ajisrawi/hologuard-hg1-radar/board/renders/HG1-ANT_iso_bottom.png

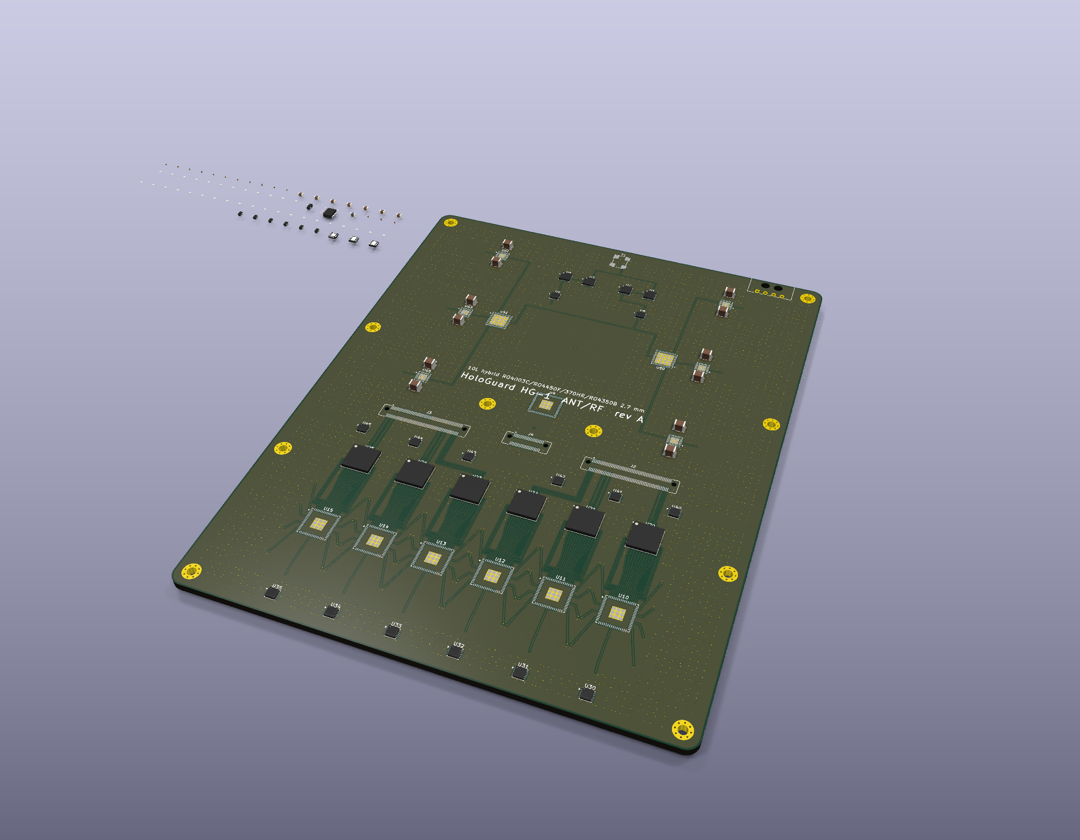
board/renders/HG1-ANT_iso_bottom.png
