ajisrawi/hologuard-hg1-radar/board/renders/HG1-ANT_top.png

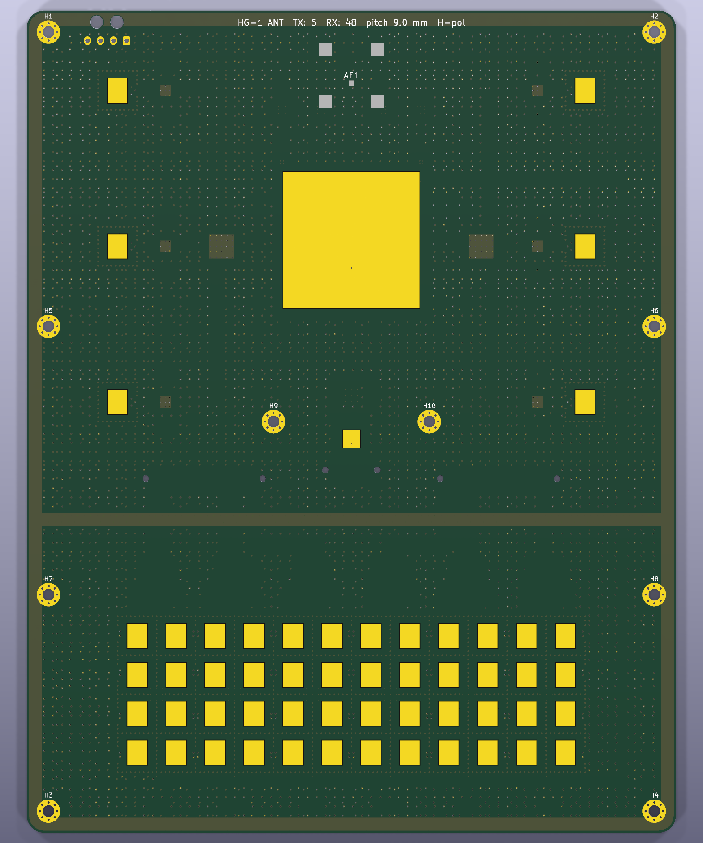
board/renders/HG1-ANT_top.png
