ajisrawi/hologuard-hg1-radar/board/renders/HG1-PWR_bottom.png

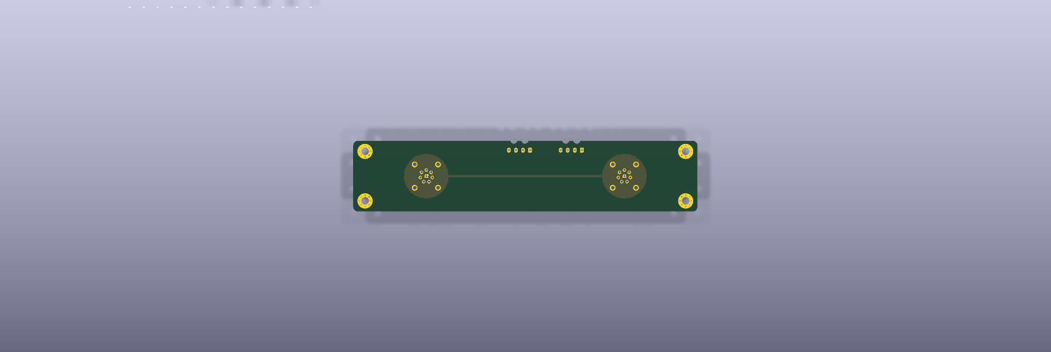
board/renders/HG1-PWR_bottom.png
