ajisrawi/hologuard-hg1-radar/board/schematic/pdf/HG1-ANT_detail.png

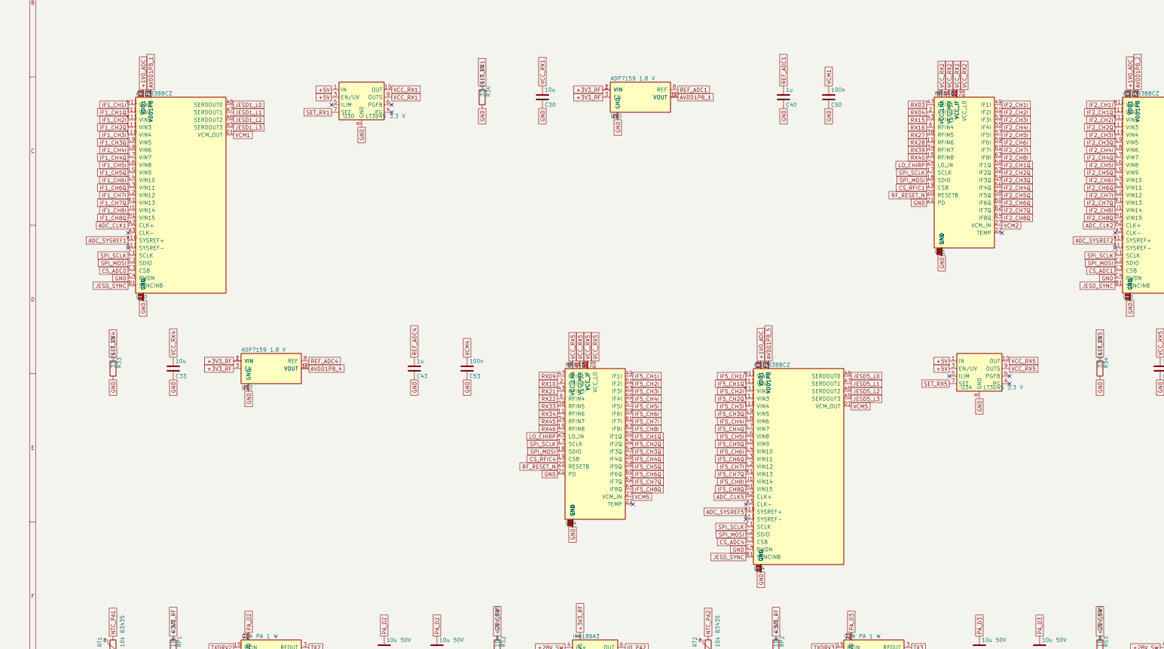
board/schematic/pdf/HG1-ANT_detail.png
