ajisrawi/hologuard-hg1-radar/board/schematic/pdf/HG1-DSP_overview.png

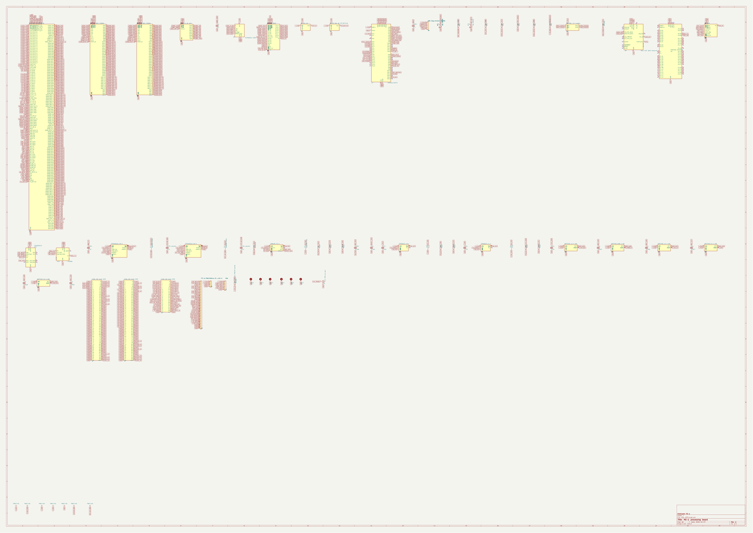
board/schematic/pdf/HG1-DSP_overview.png
