ajisrawi/hologuard-hg1-radar/board/schematic/pdf/HG1-PWR_detail.png

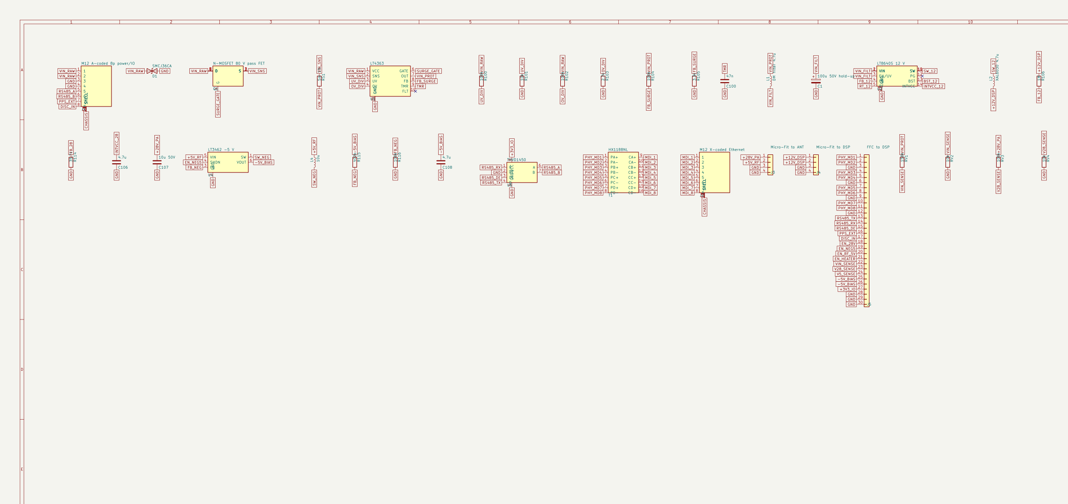
board/schematic/pdf/HG1-PWR_detail.png
