ajisrawi/hologuard-hg1-radar/board/schematic/pdf/HG1-PWR_overview.png

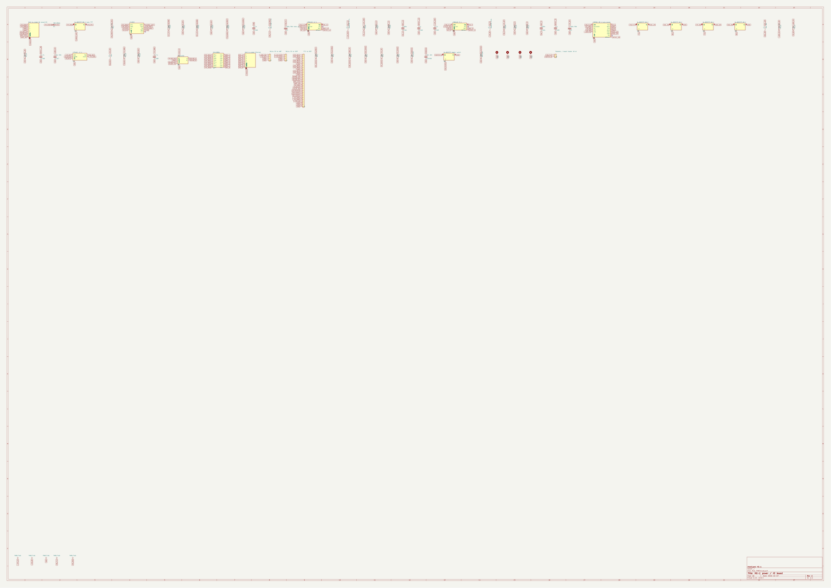
board/schematic/pdf/HG1-PWR_overview.png
