ajisrawi/hologuard-hg1-radar/mech/out/gnss_patch.stl

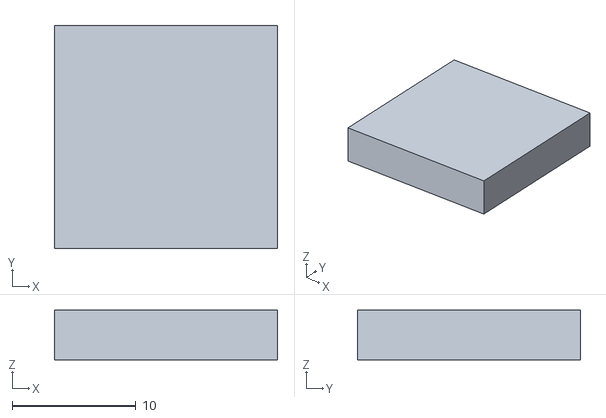
[picture p32: CAD file, 2026-10-08]
mech/out/gnss_patch.stl
18.0 x 18.0 x 4.00
