ajisrawi/hologuard-hg1-radar/mech/out/iso_fence.stl

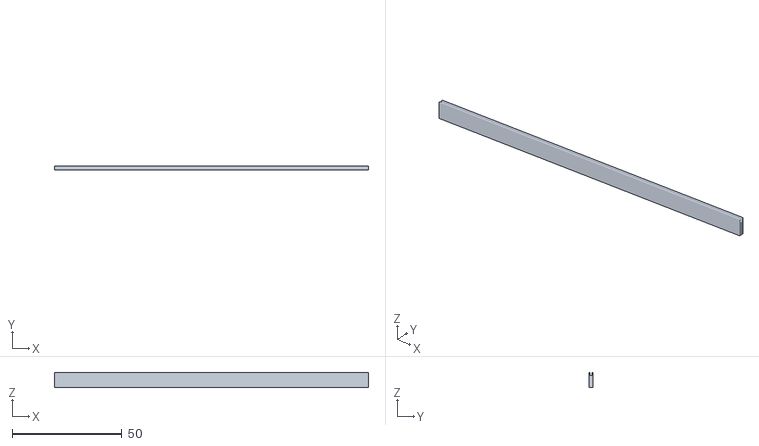
[picture p33: CAD file, 2026-10-08]
mech/out/iso_fence.stl
143.0 x 2.00 x 6.98
