ajisrawi/hologuard-hg1-radar/mech/out/ant_pcb.stl

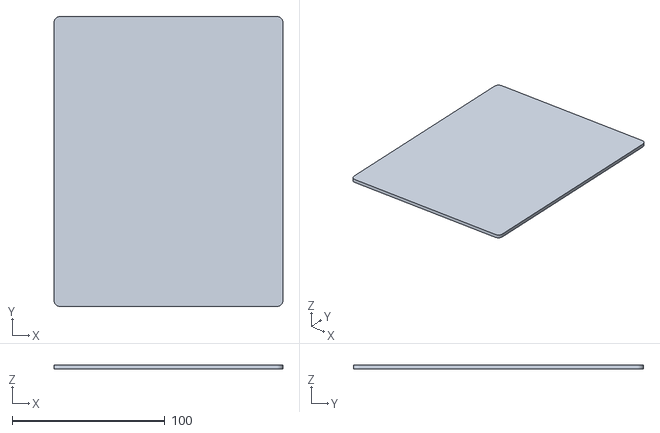
[picture p34: CAD file, 2026-10-08]
mech/out/ant_pcb.stl
150.0 x 190.0 x 2.72
