ajisrawi/hologuard-hg1-radar/mech/out/HG1_enclosure.step

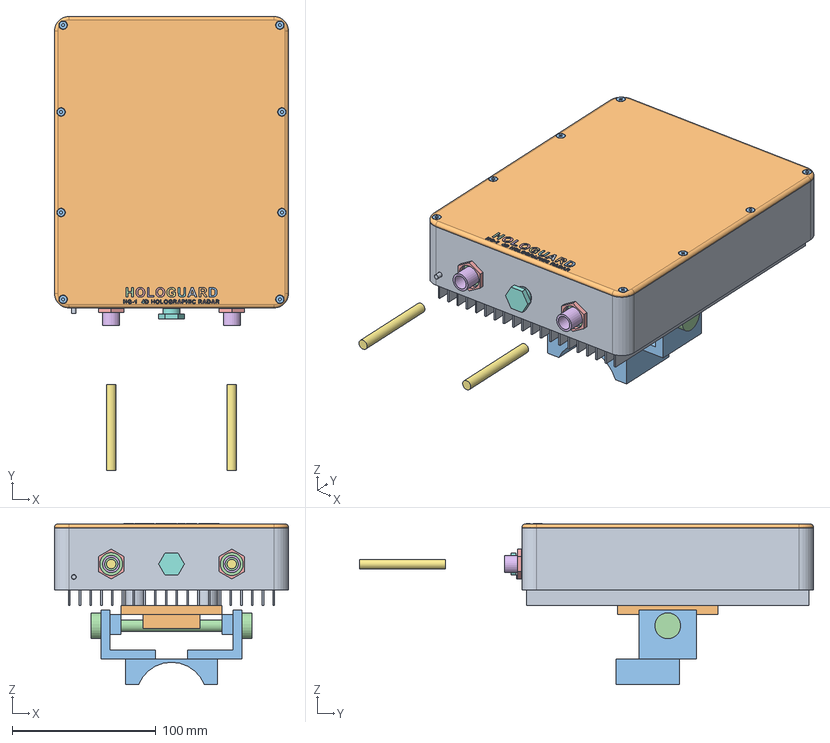
[picture p35: CAD file, 2026-10-08]
mech/out/HG1_enclosure.step
163.0 x 316.2 x 112.3 mm
housing
radome
radome_screws
logo
ant_pcb
ant_copper
gnss_patch
iso_fence
absorber
shield_frame
dsp_pcb
versal
tim_pad
pwr_pcb
connectors
bracket
bracket_hw
