ajisrawi/hologuard-hg1-radar/mech/out/ant_copper.stl

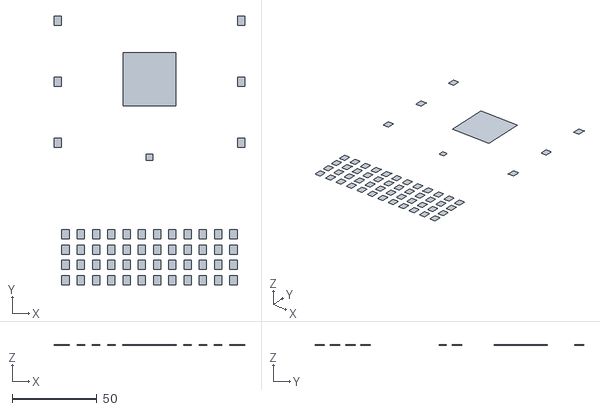
[picture p36: CAD file, 2026-10-08]
mech/out/ant_copper.stl
112.5 x 158.6 x 0.06
