ajisrawi/hologuard-hg1-radar/mech/out/pole.stl

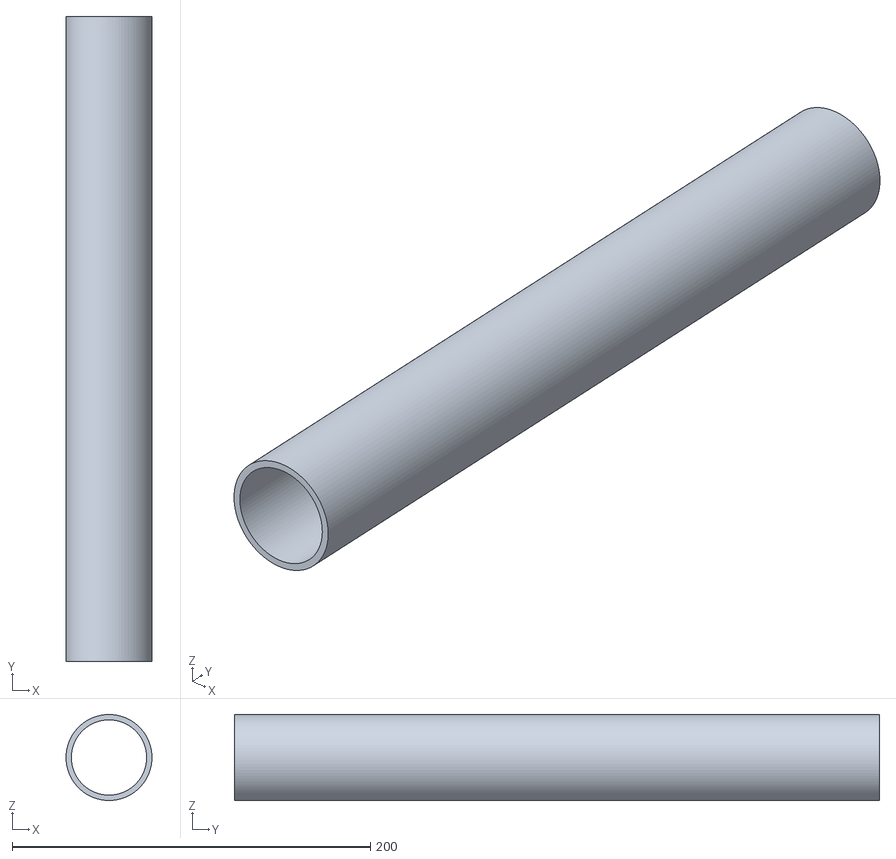
[picture p37: CAD file, 2026-10-07]
mech/out/pole.stl
48.0 x 360.0 x 48.0
