ajisrawi/hologuard-hg1-radar/mech/out/m12_plugs.stl

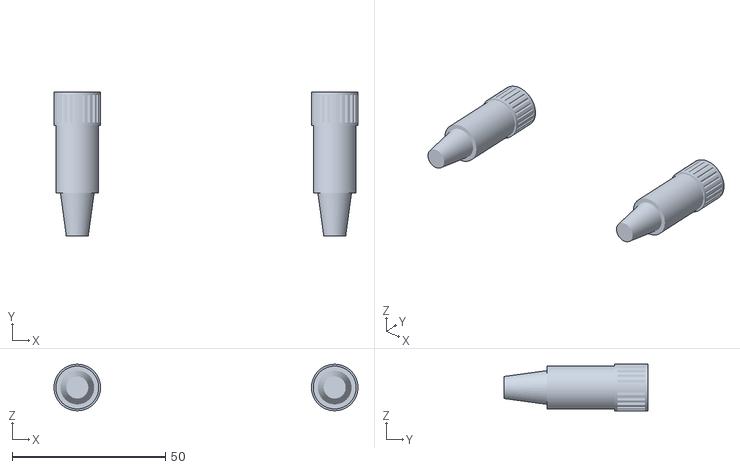
[picture p38: CAD file, 2026-10-07]
mech/out/m12_plugs.stl
99.2 x 47.0 x 15.2
