ajisrawi/hologuard-hg1-radar/mech/out/bracket.stl

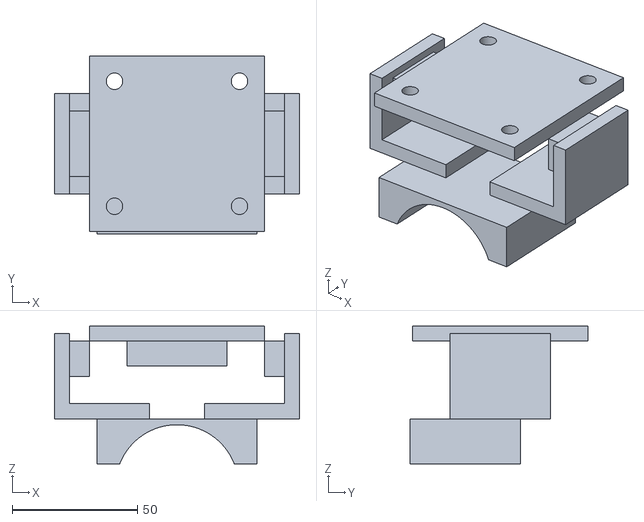
[picture p39: CAD file, 2026-10-07]
mech/out/bracket.stl
98.0 x 71.0 x 55.0
