ajisrawi/hologuard-hg1-radar/mech/out/connectors.stl

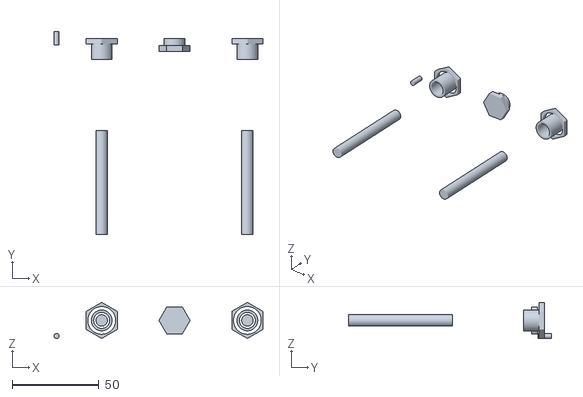
[picture p40: CAD file, 2026-10-07]
mech/out/connectors.stl
120.5 x 117.2 x 20.9
