ajisrawi/hologuard-hg1-radar/mech/out/radome.stl

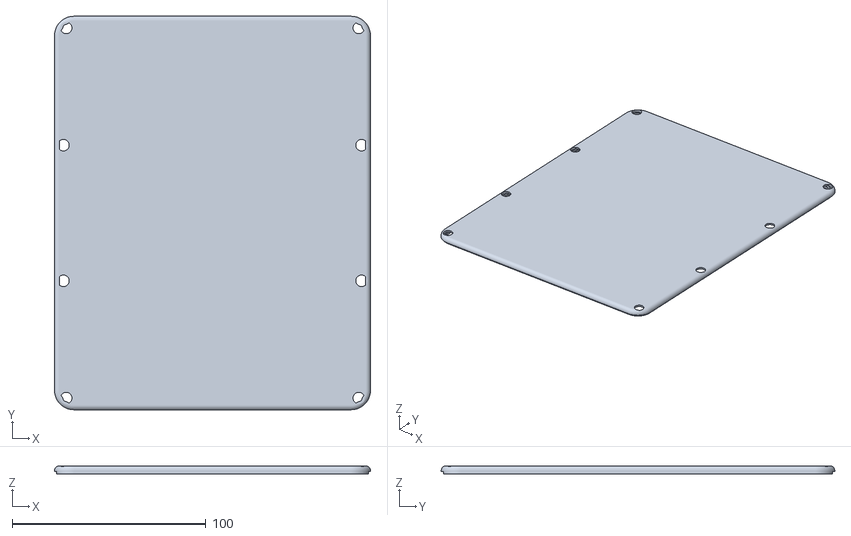
[picture p41: CAD file, 2026-10-07]
mech/out/radome.stl
163.0 x 203.0 x 4.20
