ajisrawi/hologuard-hg1-radar/mech/out/tim_pad.stl

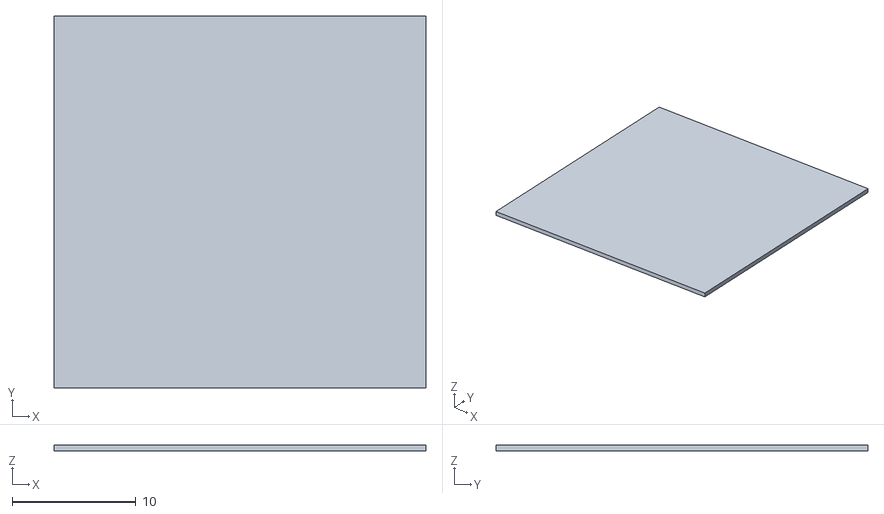
[picture p42: CAD file, 2026-10-07]
mech/out/tim_pad.stl
30.0 x 30.0 x 0.5
