ajisrawi/hologuard-hg1-radar/mech/out/versal.stl

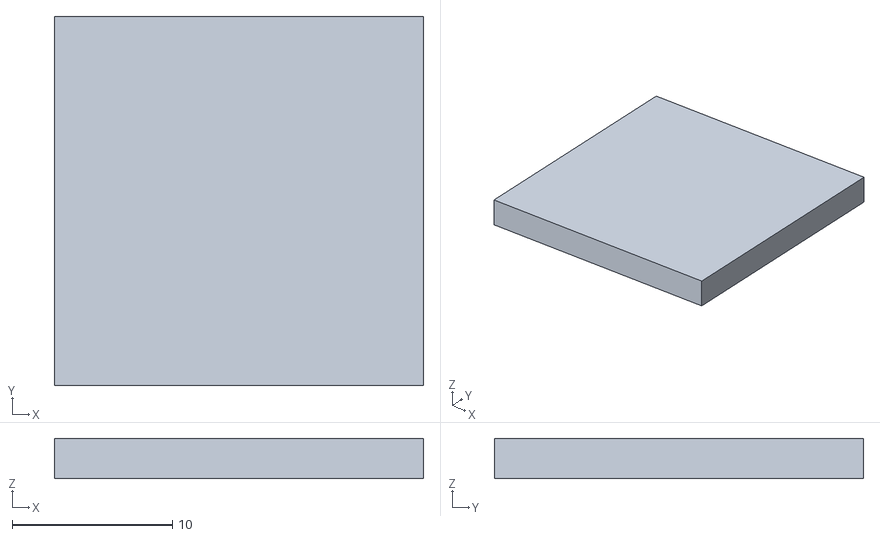
[picture p43: CAD file, 2026-10-07]
mech/out/versal.stl
23.0 x 23.0 x 2.50
