ajisrawi/hologuard-hg1-radar/mech/out/absorber.stl

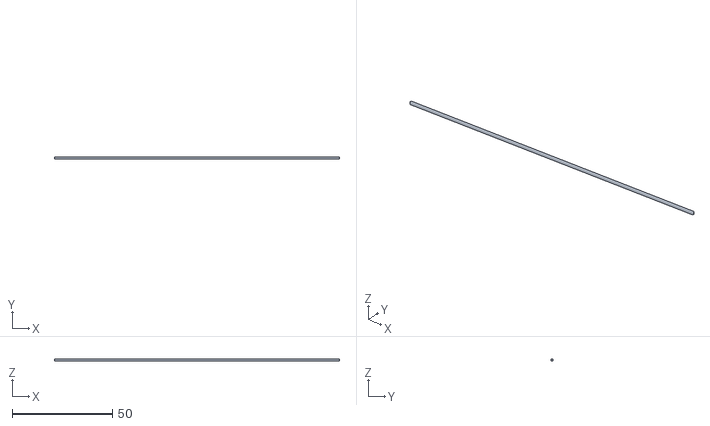
[picture p44: CAD file, 2026-10-07]
mech/out/absorber.stl
142.0 x 0.8 x 1.20
