ajisrawi/hologuard-hg1-radar/mech/out/bracket_hw.stl

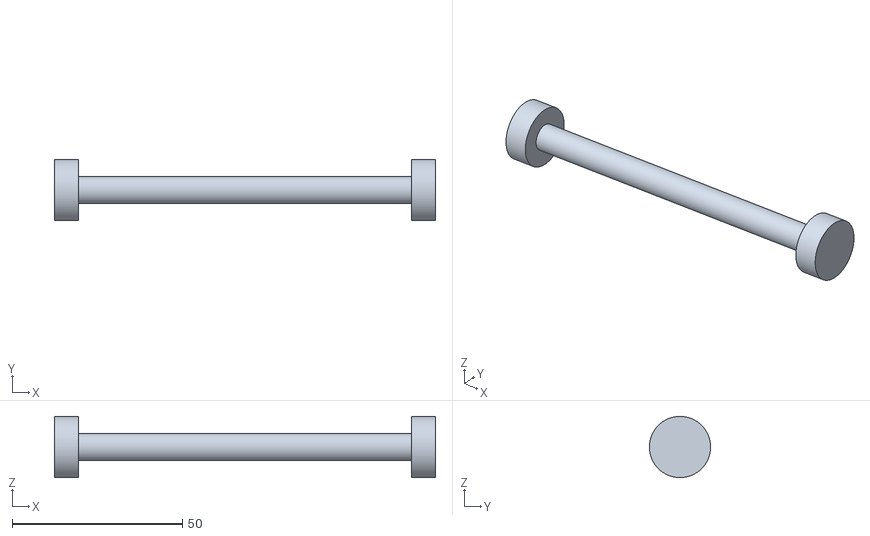
[picture p45: CAD file, 2026-10-07]
mech/out/bracket_hw.stl
112.0 x 18.0 x 18.0
