ajisrawi/hologuard-hg1-radar/mech/out/pwr_pcb.stl

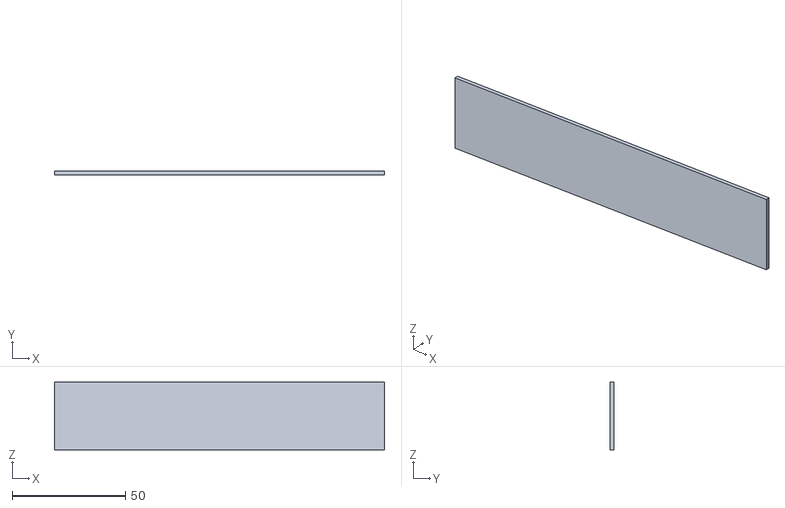
[picture p46: CAD file, 2026-10-07]
mech/out/pwr_pcb.stl
146.0 x 1.60 x 30.0
