ajisrawi/hologuard-hg1-radar/mech/out/shield_frame.stl

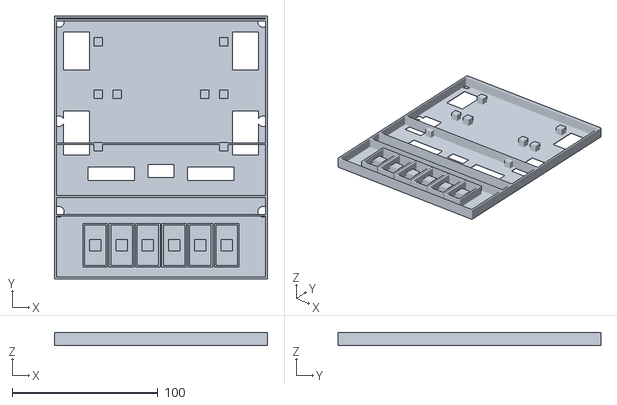
[picture p47: CAD file, 2026-10-07]
mech/out/shield_frame.stl
146.0 x 180.0 x 8.85
