ajisrawi/hologuard-hg1-radar/mech/out/housing.stl

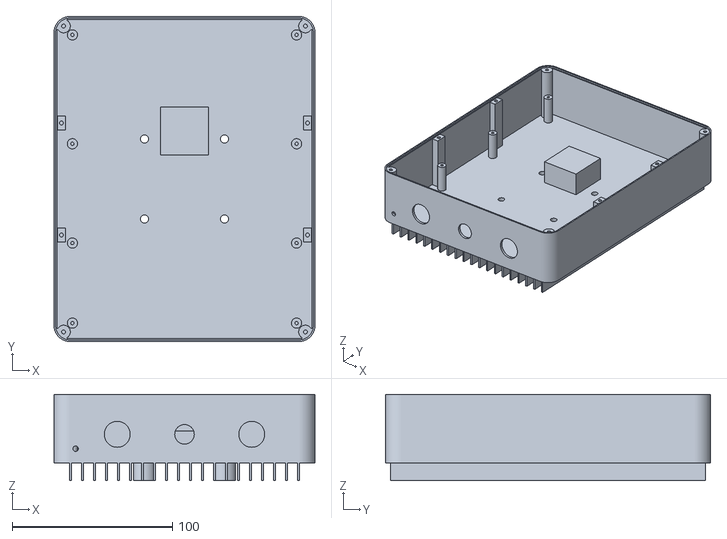
[picture p48: CAD file, 2026-10-07]
mech/out/housing.stl
163.0 x 203.0 x 54.0
