ajisrawi/hologuard-hg1-radar/mech/out/dsp_pcb.stl

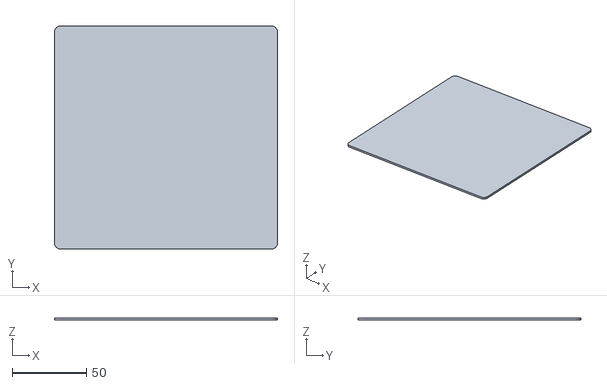
[picture p49: CAD file, 2026-10-07]
mech/out/dsp_pcb.stl
150.0 x 150.0 x 1.60
