ajisrawi/hologuard-hg1-radar/mech/out/logo.stl

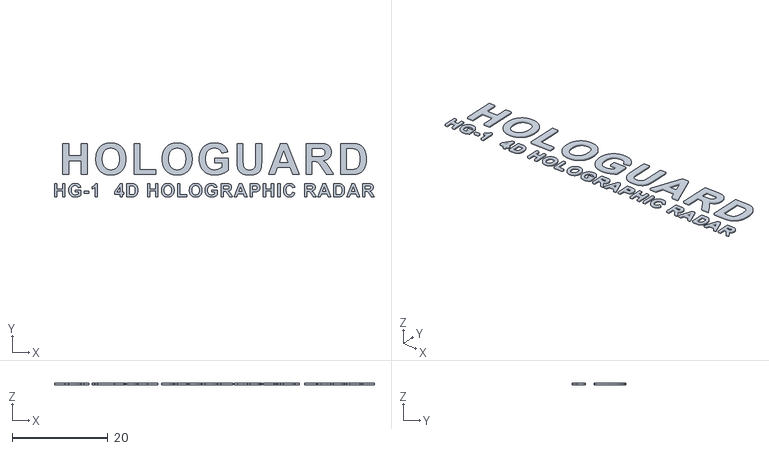
[picture p50: CAD file, 2026-10-07]
mech/out/logo.stl
66.9 x 11.4 x 0.35
