ajisrawi/hologuard-hg1-radar/(list of files, cad)

Other CAD files:
mech/out/HG1_enclosure.FCStd
mech/out/radome_screws.stl
render/HG1_scene.blend
