ajisrawi/hologuard-hg1-radar/antenna/em/results/opt_log.csv

n | drv_l | par_l | slot_l | arm_l | stub | cost_dB
1 | 3.000 | 4.250 | 4.088 | 1.600 | 2.772 | -12.78
2 | 3.150 | 4.250 | 4.088 | 1.600 | 2.772 | -7.89
3 | 3.000 | 4.450 | 4.088 | 1.600 | 2.772 | -10.80
4 | 3.000 | 4.250 | 4.338 | 1.600 | 2.772 | -10.81
5 | 3.000 | 4.250 | 4.088 | 1.800 | 2.772 | -8.66
