ajisrawi/hologuard-hg1-radar/antenna/em/results/opt_log_v1_worstcase.csv

n | drv_l | par_l | slot_l | arm_l | stub | worst_dB
1 | 3.600 | 4.600 | 3.600 | 1.000 | 2.500 | -1.20
2 | 3.850 | 4.600 | 3.600 | 1.000 | 2.500 | -0.28
3 | 3.600 | 4.900 | 3.600 | 1.000 | 2.500 | -0.68
4 | 3.600 | 4.600 | 4.000 | 1.000 | 2.500 | -0.73
5 | 3.600 | 4.600 | 3.600 | 1.300 | 2.500 | -0.74
7 | 3.700 | 4.720 | 3.760 | 1.120 | 2.200 | -0.32
