ajisrawi/hologuard-hg1-radar/antenna/em/results/opt_log_v2a.csv

n | drv_l | par_l | slot_l | arm_l | stub | cost_dB
1 | 3.600 | 4.600 | 3.600 | 1.000 | 2.500 | -4.98
2 | 3.850 | 4.600 | 3.600 | 1.000 | 2.500 | -1.08
3 | 3.600 | 4.900 | 3.600 | 1.000 | 2.500 | -3.27
4 | 3.600 | 4.600 | 4.000 | 1.000 | 2.500 | -2.91
5 | 3.600 | 4.600 | 3.600 | 1.300 | 2.500 | -2.66
6 | 3.600 | 4.600 | 3.600 | 1.000 | 2.800 | -5.24
7 | 3.350 | 4.720 | 3.760 | 1.120 | 2.620 | -7.18
8 | 3.100 | 4.780 | 3.840 | 1.180 | 2.680 | -4.90
9 | 3.500 | 4.768 | 3.824 | 0.748 | 2.668 | -6.19
10 | 3.460 | 4.835 | 3.354 | 0.947 | 2.735 | -4.93
11 | 3.404 | 4.509 | 3.655 | 0.926 | 2.829 | -6.47
12 | 3.522 | 4.444 | 4.022 | 0.970 | 2.632 | -5.80
13 | 3.350 | 4.616 | 3.944 | 0.906 | 2.920 | -7.07
14 | 3.250 | 4.623 | 4.082 | 0.868 | 2.667 | -5.67
15 | 3.338 | 4.617 | 3.962 | 0.901 | 2.701 | -7.16
16 | 3.255 | 4.849 | 3.636 | 0.870 | 2.863 | -2.44
17 | 3.455 | 4.545 | 3.926 | 0.945 | 2.690 | -7.72
18 | 3.259 | 4.435 | 3.875 | 1.171 | 2.836 | -9.16
19 | 3.138 | 4.269 | 3.900 | 1.383 | 2.919 | -11.19
20 | 3.248 | 4.598 | 4.142 | 1.176 | 2.710 | -8.81
21 | 3.262 | 4.483 | 3.931 | 1.304 | 2.536 | -8.86
22 | 3.244 | 4.428 | 3.902 | 1.470 | 2.690 | -7.83
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
