ajisrawi/hologuard-hg1-radar/antenna/em/results/optm_log.csv

gen | idx | drv_l | par_l | slot_l | arm_l | stub | h_par | cost_dB | per_angle_dB
0 | 0 | 3.0000 | 4.2500 | 4.0880 | 1.6000 | 2.7720 | 1.5240 | -3.21 | -11.50 -6.19 -3.21
0 | 1 | 3.8086 | 4.8620 | 3.9450 | 1.6952 | 2.7925 | 1.2190 | -0.59 | -0.59 -0.71 -5.66
0 | 2 | 3.3720 | 4.9911 | 2.9958 | 1.3785 | 2.9988 | 1.0160 | -1.46 | -1.99 -1.46 -3.33
0 | 3 | 2.8249 | 4.3546 | 2.5397 | 0.4218 | 1.7623 | 1.0160 | -0.34 | -0.34 -0.57 -2.39
0 | 4 | 2.9572 | 5.4184 | 4.4028 | 1.2173 | 2.6609 | 0.8130 | -1.03 | -1.34 -1.03 -2.90
0 | 5 | 2.5837 | 4.4555 | 4.5124 | 0.9871 | 1.8301 | 1.2190 | -1.81 | -1.81 -1.81 -2.89
0 | 6 | 3.0067 | 4.1453 | 3.2019 | 2.0601 | 2.2592 | 1.2190 | -8.05 | -11.34 -8.05 -10.37
0 | 7 | 3.5892 | 4.2299 | 4.0003 | 0.5114 | 2.5886 | 1.5240 | -2.63 | -6.56 -4.58 -2.63
0 | 8 | 3.9888 | 5.4022 | 3.6398 | 1.9846 | 2.1501 | 1.2190 | -0.06 | -0.06 -0.06 -0.12
0 | 9 | 2.8064 | 5.1414 | 2.6027 | 1.9028 | 1.6124 | 1.2190 | -1.64 | -2.20 -1.64 -1.92
0 | 10 | 3.2419 | 4.6582 | 3.5945 | 0.7380 | 2.7198 | 1.0160 | -0.94 | -1.03 -0.94 -2.50
0 | 11 | 2.4989 | 3.5233 | 2.4000 | 1.0241 | 1.9506 | 1.2190 | -2.08 | -2.08 -6.17 -7.66
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
