ajisrawi/hologuard-hg1-radar/firmware/sim/results/microdoppler_feature.png

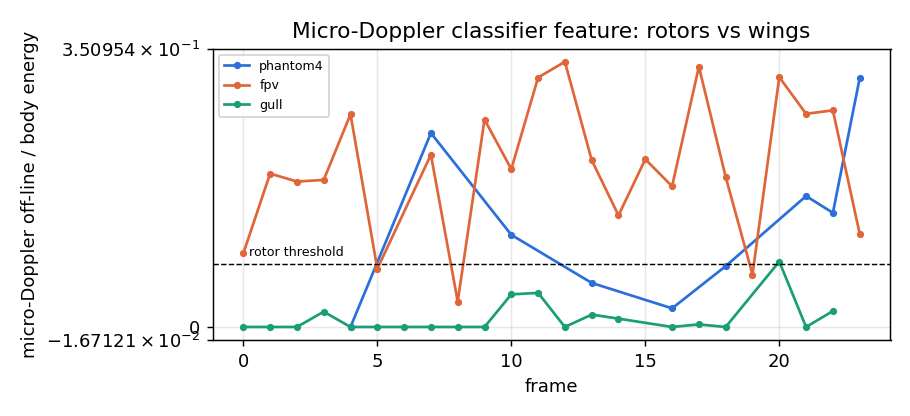
firmware/sim/results/microdoppler_feature.png
