ajisrawi/hologuard-hg1-radar/firmware/sim/results/tracks_vs_truth.png

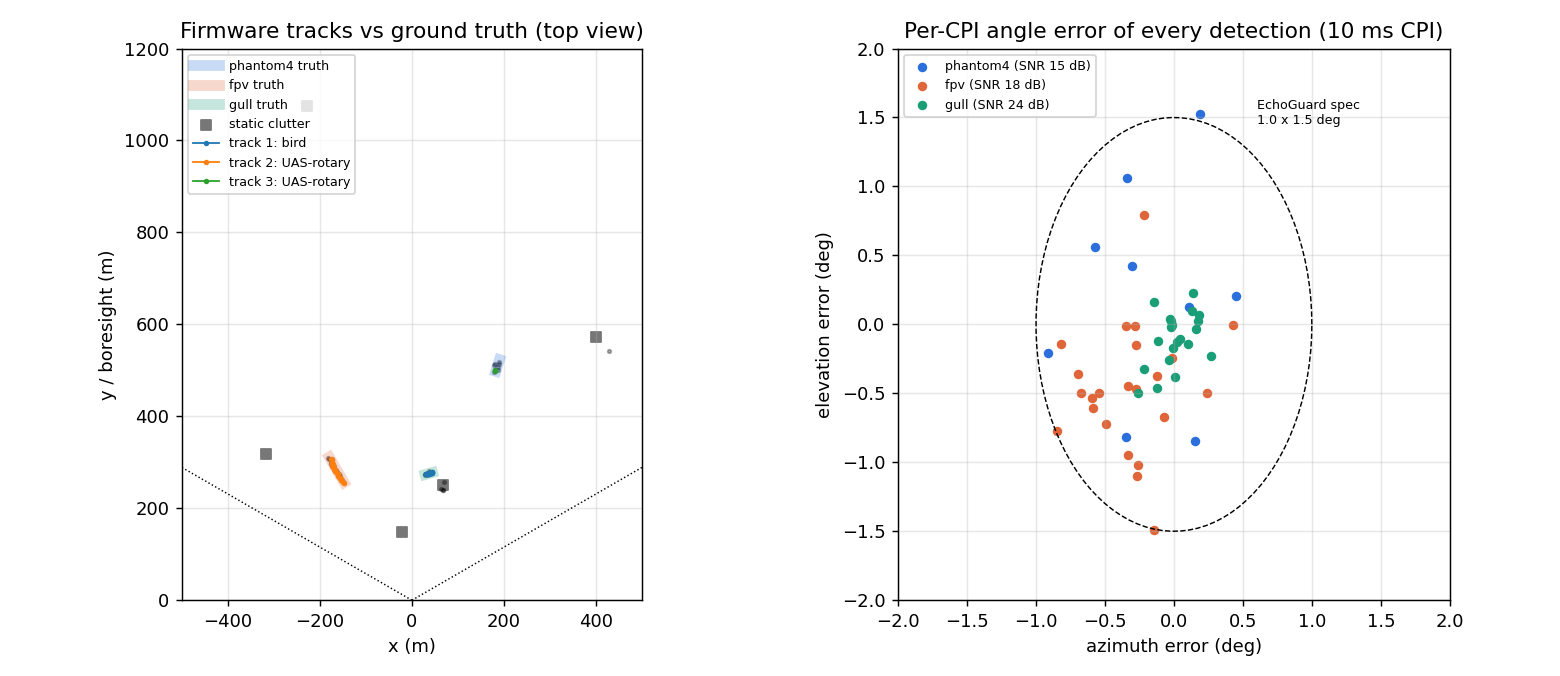
firmware/sim/results/tracks_vs_truth.png
