ajisrawi/hologuard-hg1-radar/board/schematic/pdf/HG1-ANT.pdf

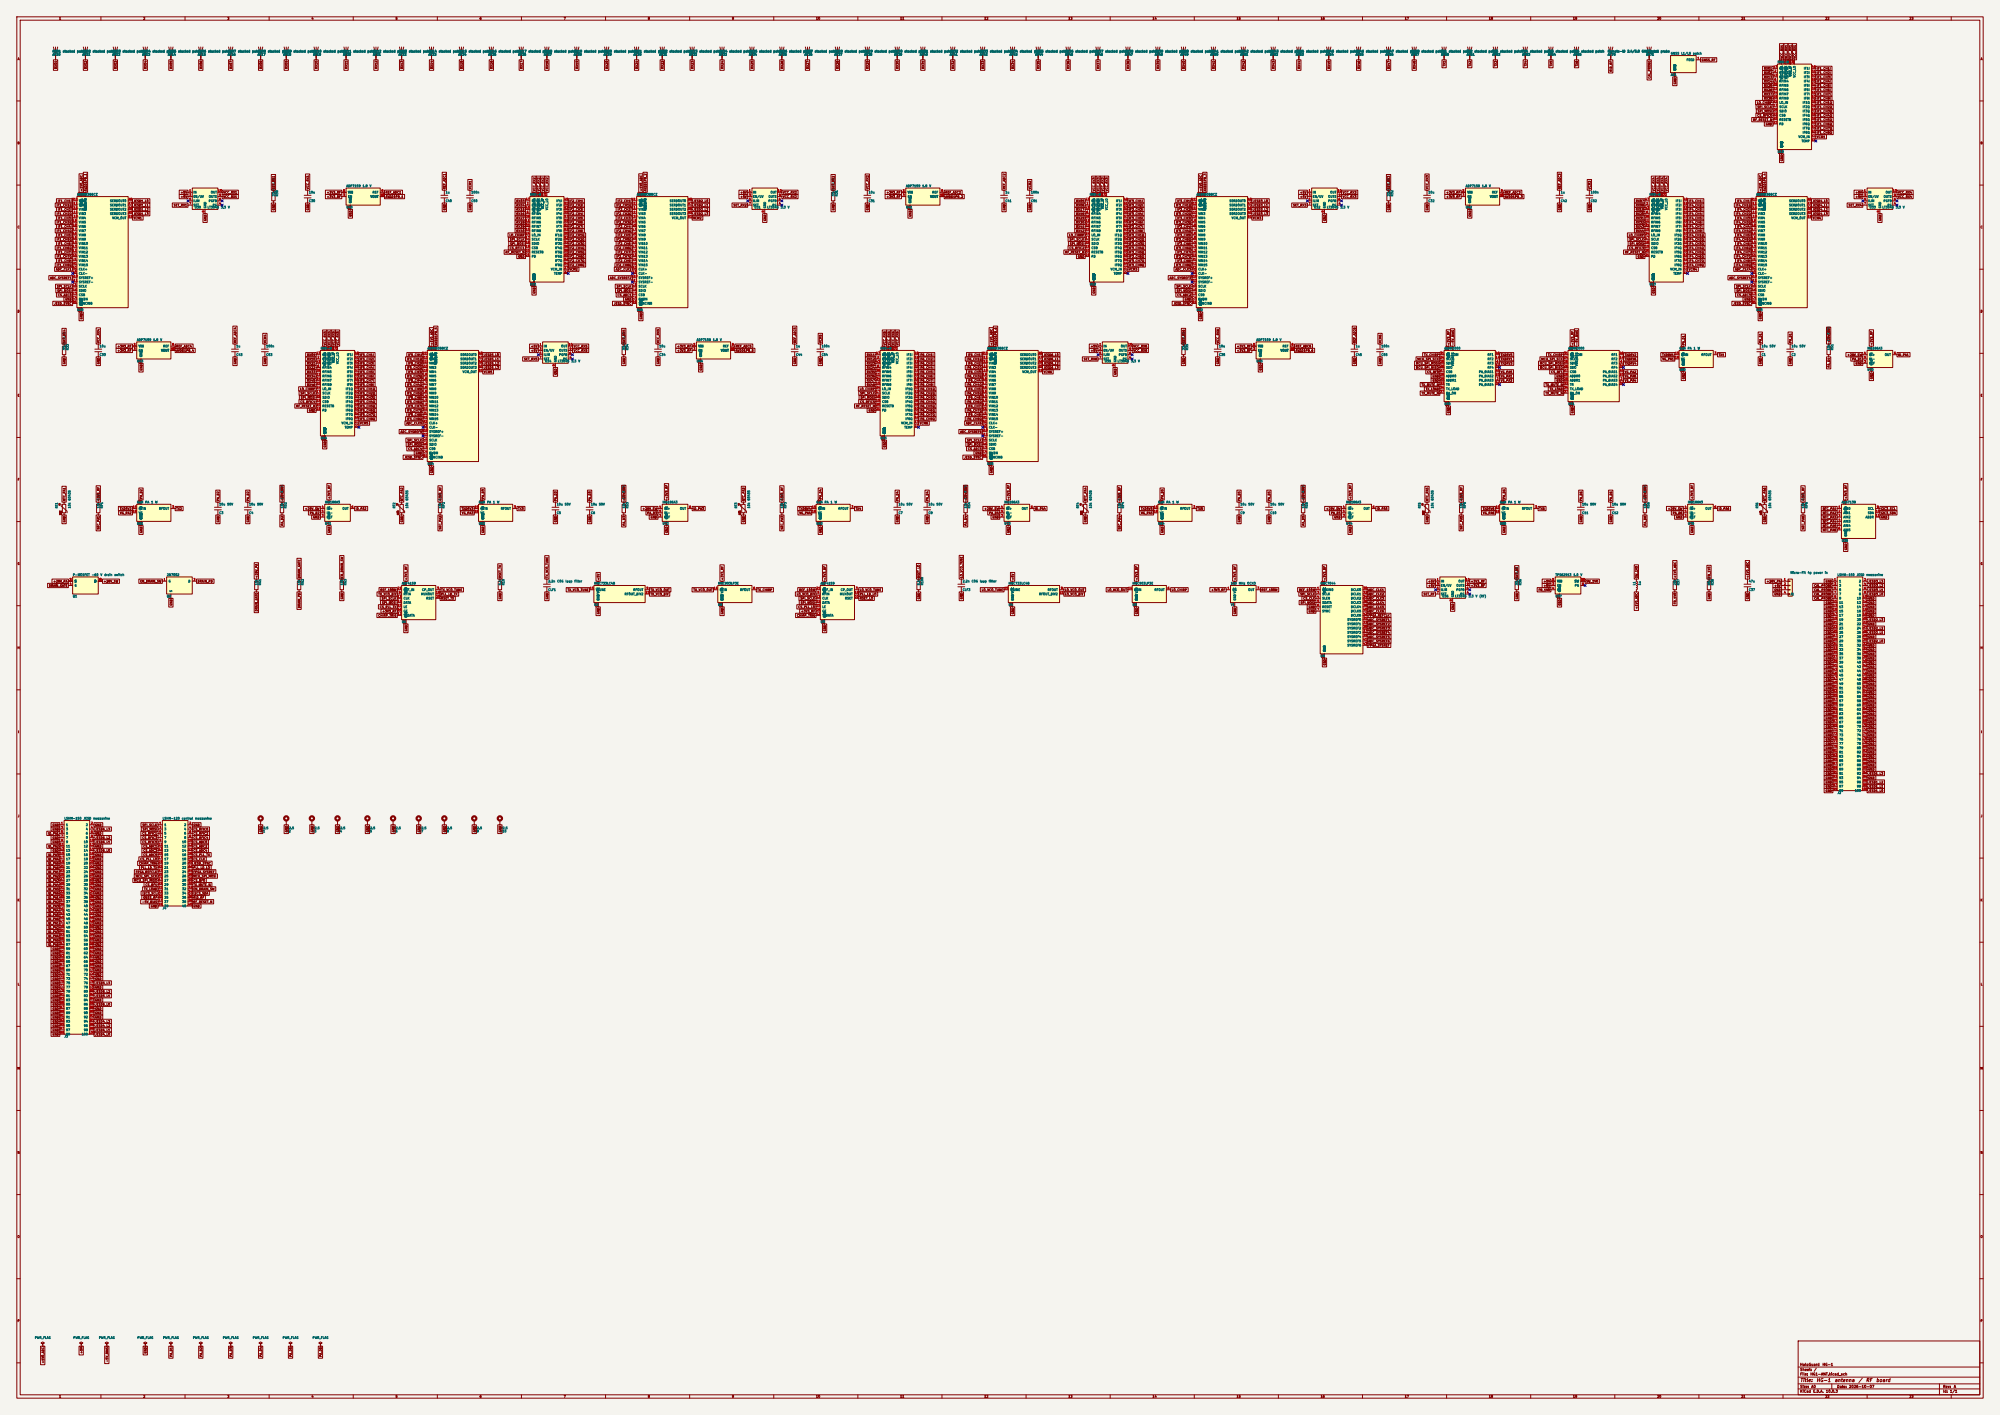
[picture p53: page 1]

HoloGuard HG-1
Sheet: /
File: HG1-ANT.kicad_sch
Title: HG-1 antenna / RF board

Size: A0 | Rev: A
KiCad E.D.A. 10.0.3 | Id: 1/1
