ajisrawi/hologuard-hg1-radar/board/schematic/pdf/HG1-DSP.pdf

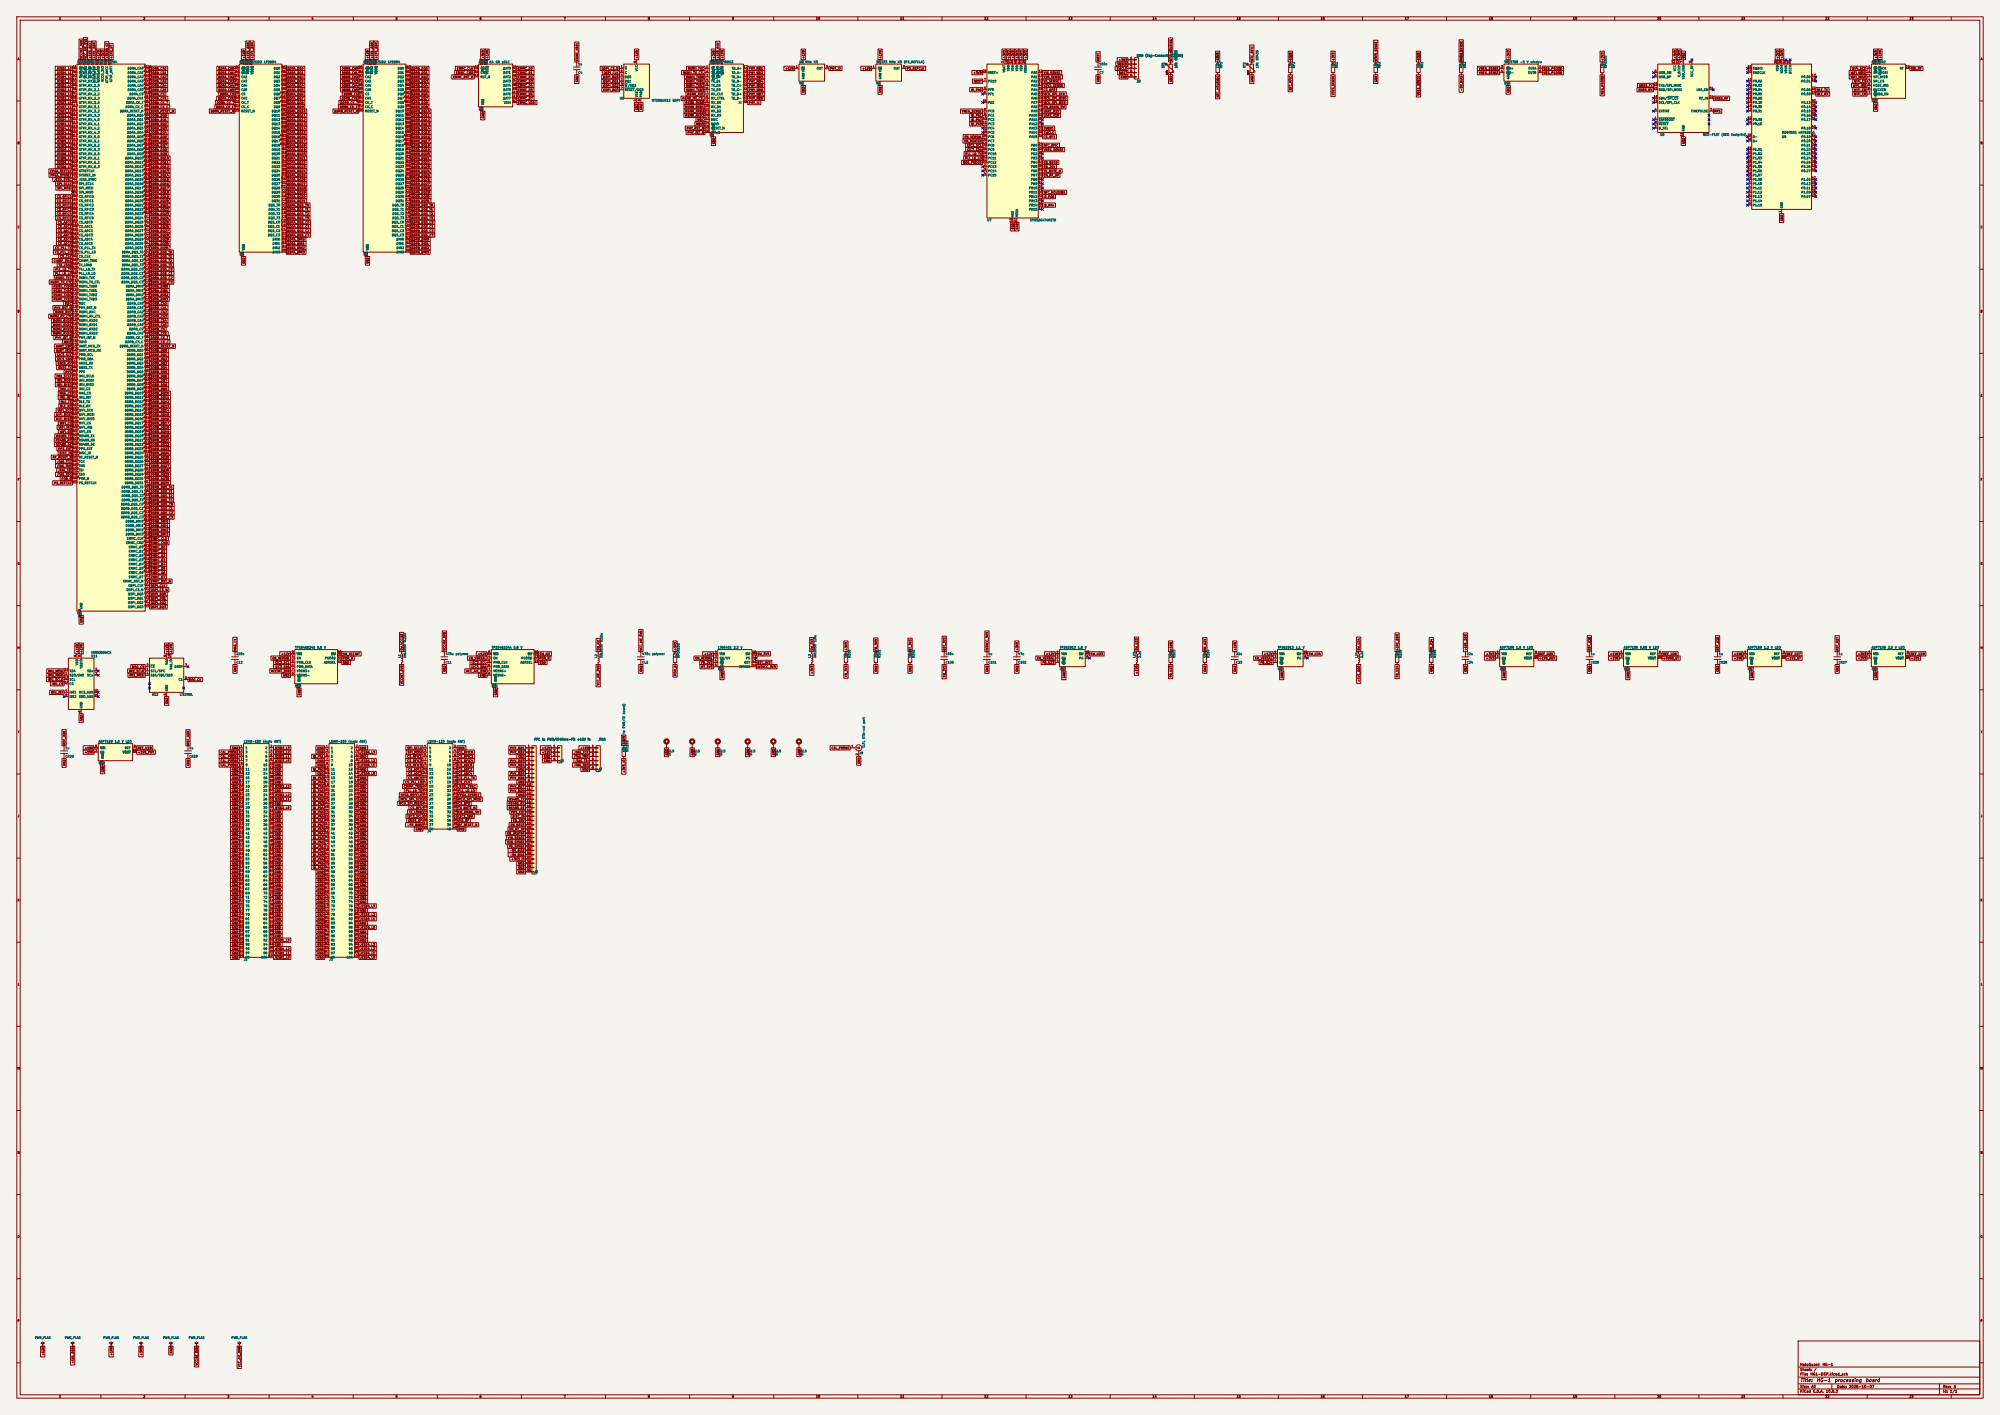
[picture p54: page 1]

TDO AG27POR_B AG28PS_REFCLK AH1 VCCINT AH2 VCC_AIE AH3 VCCAUX AH4 VCCO_DDR AH5 VCCO_1V8 AH6 VCCO_3V3 AH7 GTYP_AVCC AH8 GTYP_AVTT AH9 GND AH10 U1

2J9 U.FL OTA-cal port

FFC to PWR/IO

Sheet: /
File: HG1-DSP.kicad_sch
Title: HG-1 processing board

Size: A0 | Rev: A
KiCad E.D.A. 10.0.3 | Id: 1/1
