ajisrawi/hologuard-hg1-radar/board/schematic/pdf/HG1-PWR.pdf

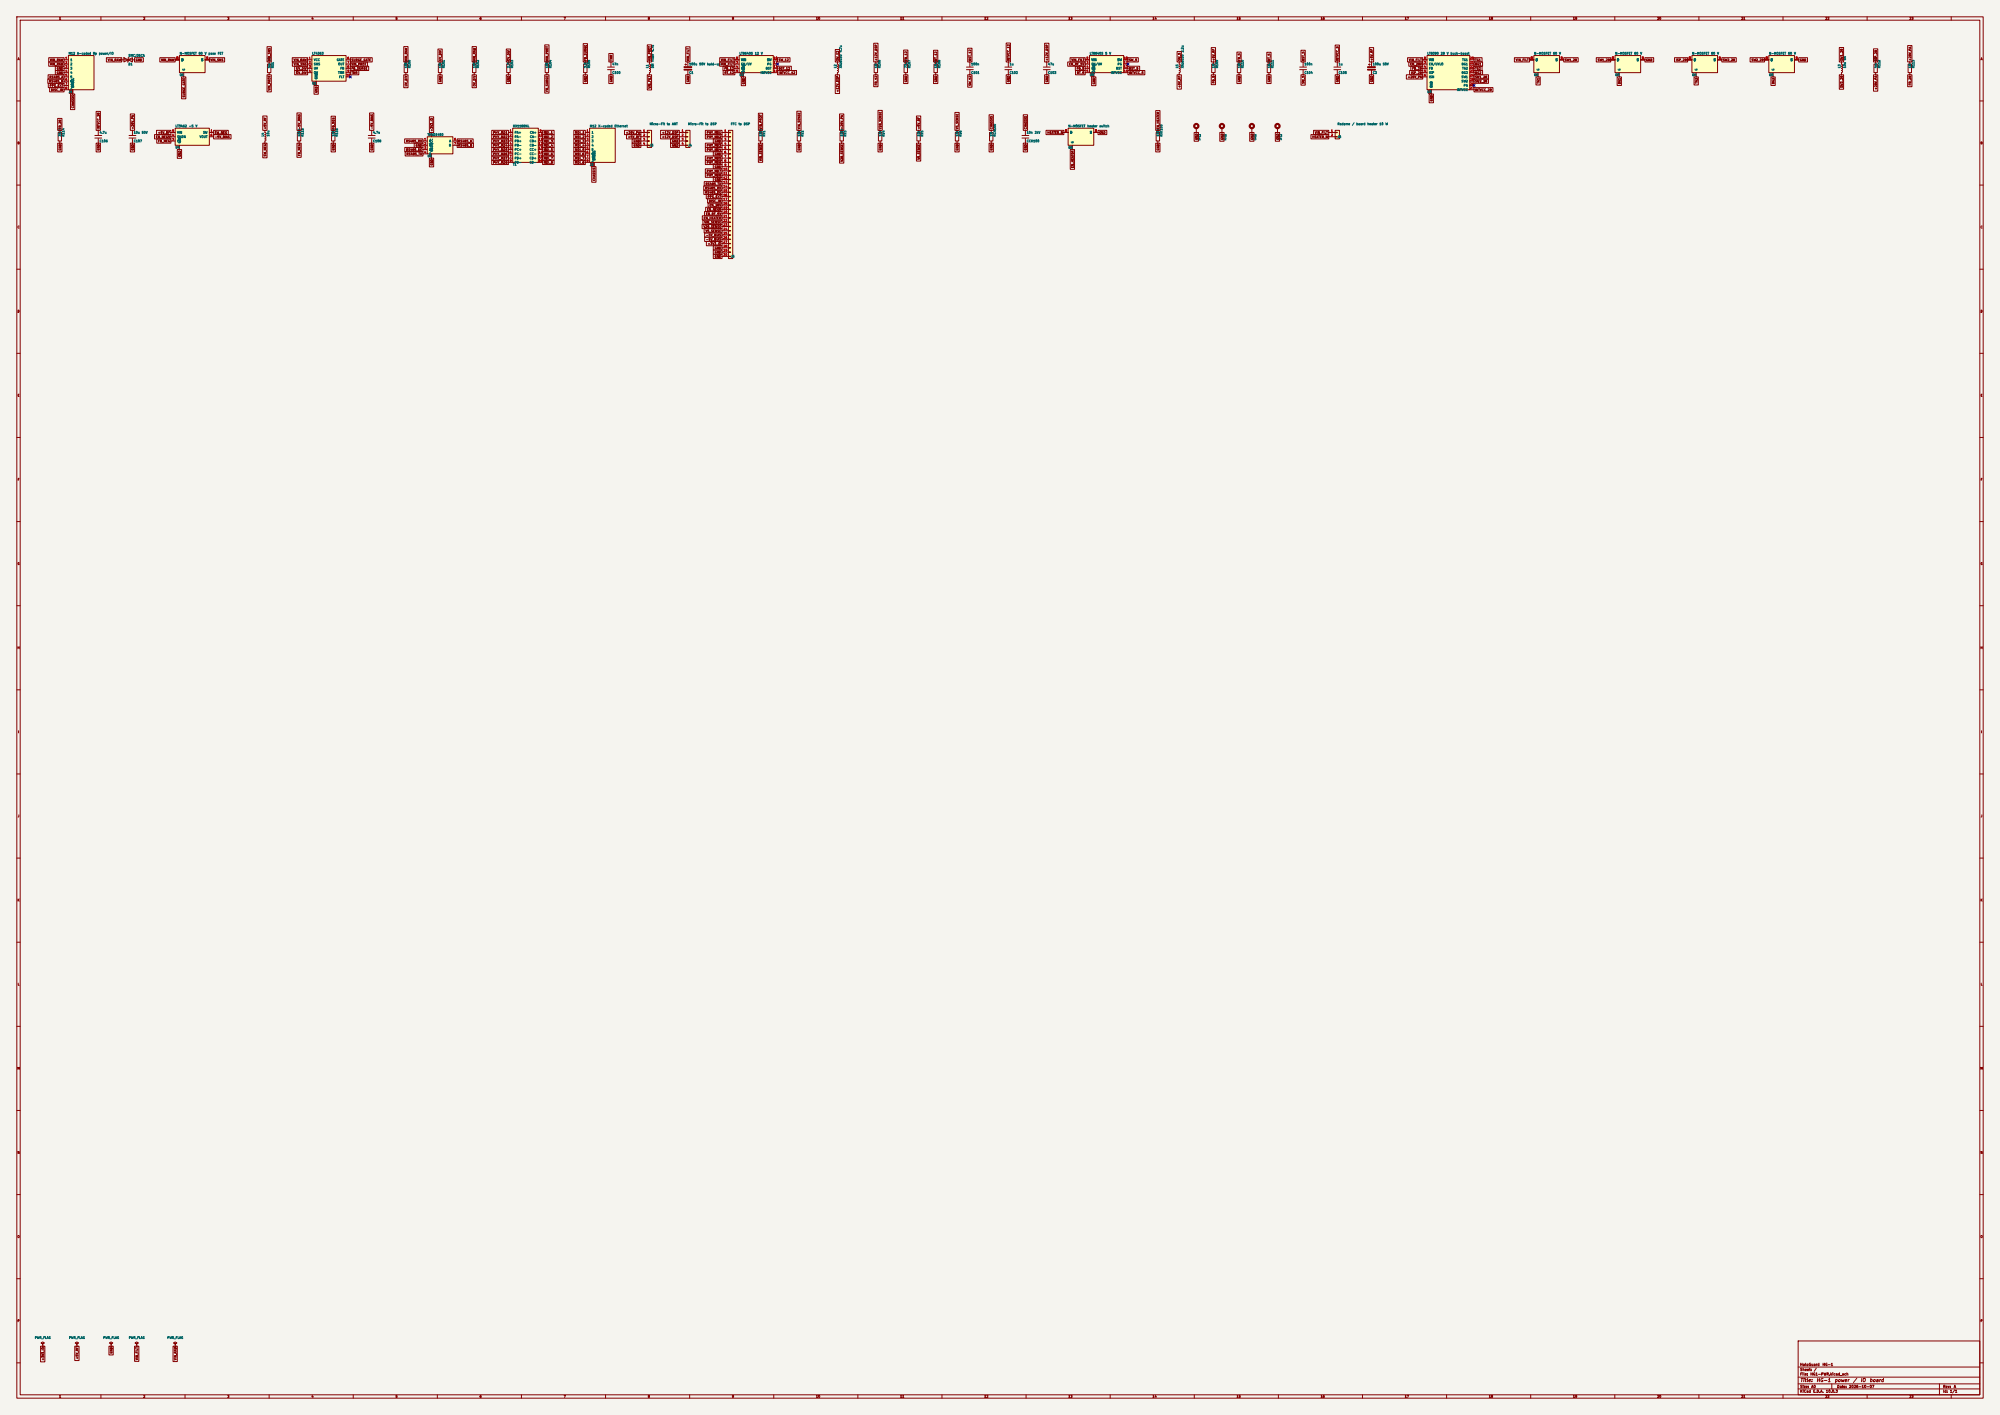
[picture p55: page 1]

HoloGuard HG-1
Sheet: /
File: HG1-PWR.kicad_sch
Title: HG-1 power / IO board

Size: A0 | Rev: A
KiCad E.D.A. 10.0.3 | Id: 1/1
