ajisrawi/hologuard-hg1-radar/board/kicad/HG1-ANT.kicad_pcb

## KiCad design board/kicad/HG1-ANT.kicad_pcb (2026-10-08)

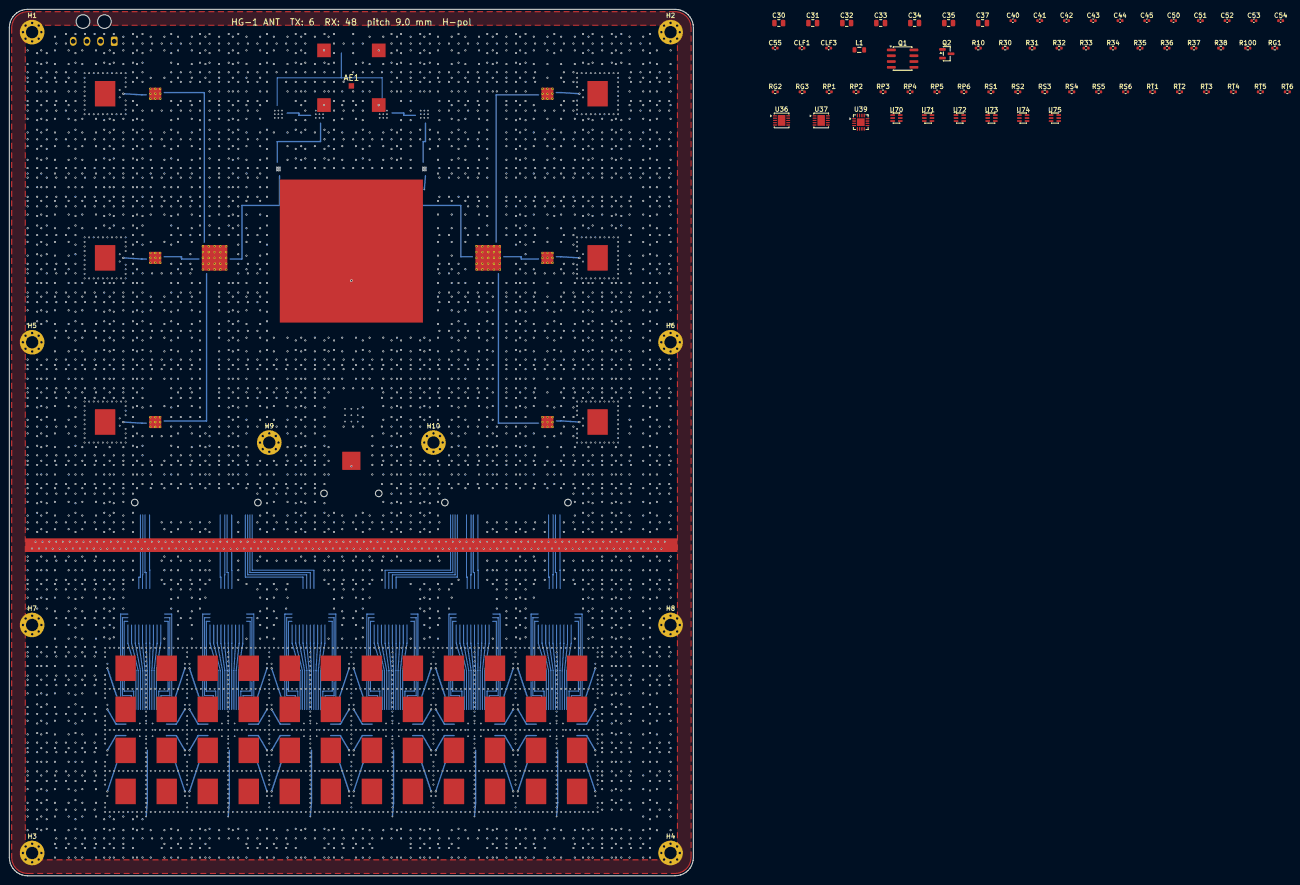
[picture p56: board HG1-ANT.kicad_pcb from above]

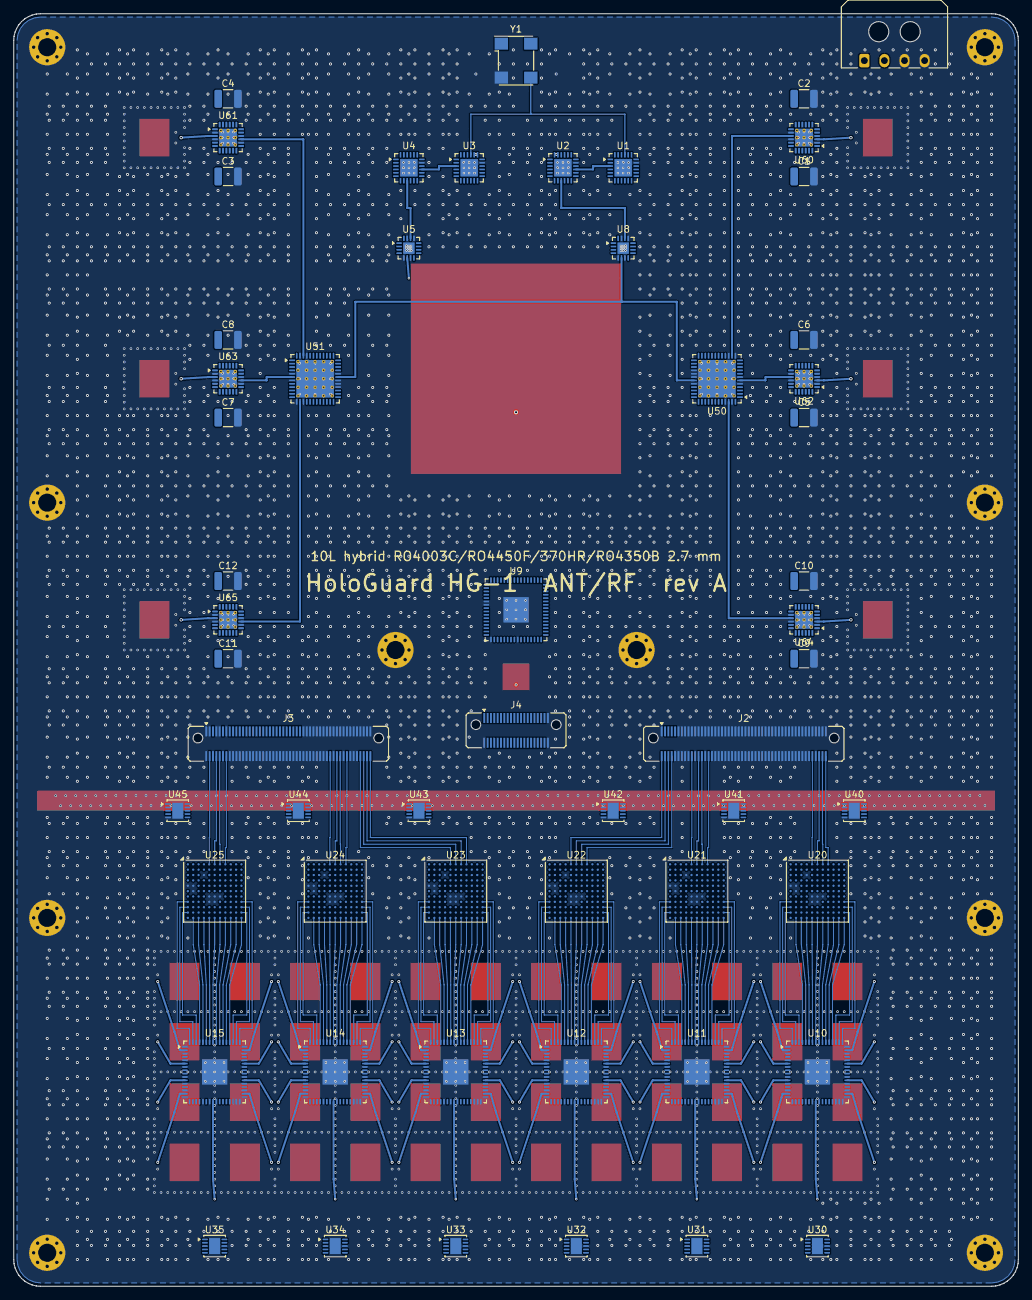
[picture p57: board HG1-ANT.kicad_pcb from below]

Board: 10 copper layers, 150.0 x 190.0 mm, 132 parts (56 on the bottom side), 251 nets.

Parts:
AE1: GNSS L1/L5 patch; GNSS_PATCH_18x18
C1, C2, C3, C4, C5, C6, C7, C8, C9, C10, C11, C12: 10u 50V; C_1210_3225Metric
C30, C31, C32, C33, C34, C35: 10u; C_0805_2012Metric
C37: 47u; C_0805_2012Metric
C40, C41, C42, C43, C44, C45: 1u; C_0402_1005Metric
C50, C51, C52, C53, C54, C55: 100n; C_0402_1005Metric
CLF1, CLF3: 2.2n C0G loop filter; C_0402_1005Metric
H1, H2, H3, H4, H5, H6, H7, H8, H9, H10: M2.5; MountingHole_2.7mm_M2.5_Pad_Via
J1: Micro-Fit 4p power in; Molex_Micro-Fit_3.0_43650-0400_1x04_P3.00mm_Horizontal
J2, J3: LSHM-150 JESD mezzanine; Samtec_LSHM-150-xx.x-x-DV-N_2x50_P0.50mm_Vertical
J4: LSHM-120 control mezzanine; Samtec_LSHM-120-xx.x-x-DV-N_2x20_P0.50mm_Vertical
L1: 1u; L_0805_2012Metric
Q1: P-MOSFET -60 V drain switch; SOIC-8_3.9x4.9mm_P1.27mm
Q2: 2N7002; SOT-23
R10, R100: 5.1k; R_0402_1005Metric
R30, R31, R32, R33, R34, R35, R36: 33.2k 0.1%; R_0402_1005Metric
R37: 20k; R_0402_1005Metric
R38: 80.6k; R_0402_1005Metric
RG1, RG2: 10k; R_0402_1005Metric
RG3: 100k; R_0402_1005Metric
RP1, RP2, RP3, RP4, RP5, RP6: 10k 0.1%; R_0402_1005Metric
RS1, RS2, RS3, RS4, RS5, RS6: 10m 1% 0805; R_0402_1005Metric
RT1, RT2, RT3, RT4, RT5, RT6: 10k B3435; R_0402_1005Metric
U1, U3: ADF4159; QFN-24-1EP_4x4mm_P0.5mm_EP2.6x2.6mm
U2, U4: HMC733LC4B; QFN-24-1EP_4x4mm_P0.5mm_EP2.6x2.6mm
U5, U8: HMC903LP3E; QFN-16-1EP_3x3mm_P0.5mm_EP1.7x1.7mm
U9: HMC7044; QFN-64-1EP_9x9mm_P0.5mm_EP3.8x3.8mm
U10, U11, U12, U13, U14, U15: HRX-8; QFN-64-1EP_9x9mm_P0.5mm_EP3.8x3.8mm
U20, U21, U22, U23, U24, U25: AD9083BBCZ; BGA-121_9.0x9.0mm_Layout11x11_P0.8mm_Ball0.4mm_Pad0.35mm_NS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
U30, U31, U32, U33, U34, U35: LT3045 3.3 V; DFN-10-1EP_3x3mm_P0.5mm_EP1.65x2.38mm
U36: LT3045 3.3 V (RF); DFN-10-1EP_3x3mm_P0.5mm_EP1.65x2.38mm
U37: TPS62913 1.0 V; DFN-10-1EP_3x3mm_P0.5mm_EP1.65x2.38mm
U39: ADS7138; QFN-16-1EP_3x3mm_P0.5mm_EP1.7x1.7mm
U40, U41, U42, U43, U44, U45: ADP7159 1.8 V; DFN-10-1EP_3x3mm_P0.5mm_EP1.65x2.38mm
U50, U51: ADAR1000; QFN-48-1EP_7x7mm_P0.5mm_EP5.6x5.6mm_ThermalVias
U60, U61, U62, U63, U64, U65: GaN PA 1 W; QFN-24-1EP_4x4mm_P0.5mm_EP2.65x2.65mm_ThermalVias
U70, U71, U72, U73, U74, U75: INA186A3; SOT-363_SC-70-6
Y1: 100 MHz OCXO; Oscillator_SMD_Diodes_FN-4Pin_7.0x5.0mm

Connections:
+1V0_ADC: C37.1, L1.2, R37.1, U20.E5, U20.E6, U20.E7, U21.E5, U21.E6, U21.E7, U22.E5, U22.E6, U22.E7, U23.E5, U23.E6, U23.E7, U24.E5, U24.E6, U24.E7, U25.E5, U25.E6, U25.E7
+3V3_RF: RP1.1, RP2.1, RP3.1, RP4.1, RP5.1, RP6.1, U1.5, U1.6, U1.7, U1.8, U1.16, U3.5, U3.6, U3.7, U3.8, U3.16, U5.3, U8.3, U9.10, U9.11, U9.12, U9.13, U36.9, U36.10, U39.14, U40.1, U40.2, U40.3, U41.1, U41.2, U41.3, U42.1, U42.2, U42.3, U43.1, U43.2, U43.3, U44.1, U44.2, U44.3, U45.1, U45.2, U45.3, U50.10, U50.11, U50.21, U51.10, U51.11, U51.21, U70.1, U71.1, U72.1, U73.1, U74.1, U75.1, Y1.1, Y1.4
+5V: J1.2, U2.3, U2.4, U4.3, U4.4, U30.1, U30.2, U30.3, U31.1, U31.2, U31.3, U32.1, U32.2, U32.3, U33.1, U33.2, U33.3, U34.1, U34.2, U34.3, U35.1, U35.2, U35.3, U36.1, U36.2, U36.3, U37.1, U37.2, U37.3
+28V_PA: J1.1, Q1.1, Q1.2, Q1.3, RG1.1
+28V_SW: Q1.5, Q1.6, Q1.7, Q1.8, RS1.1, RS2.1, RS3.1, RS4.1, RS5.1, RS6.1, U70.4, U71.4, U72.4, U73.4, U74.4, U75.4
-5V_BIAS: J4.37, U50.1, U51.1
ADC_CLK1: U9.30, U20.A2
ADC_CLK2: U9.32, U21.A2
ADC_CLK3: U9.34, U22.A2
ADC_CLK4: U9.36, U23.A2
ADC_CLK5: U9.38, U24.A2
ADC_CLK6: U9.40, U25.A2
ADC_SYSREF1: U9.31, U20.A10
ADC_SYSREF2: U9.33, U21.A10
ADC_SYSREF3: U9.35, U22.A10
ADC_SYSREF4: U9.37, U23.A10
ADC_SYSREF5: U9.39, U24.A10
ADC_SYSREF6: U9.41, U25.A10
AVDD1P8_1: U20.F5, U20.F6, U20.F7, U40.9, U40.10
AVDD1P8_2: U21.F5, U21.F6, U21.F7, U41.9, U41.10
AVDD1P8_3: U22.F5, U22.F6, U22.F7, U42.9, U42.10
AVDD1P8_4: U23.F5, U23.F6, U23.F7, U43.9, U43.10
AVDD1P8_5: U24.F5, U24.F6, U24.F7, U44.9, U44.10
AVDD1P8_6: U25.F5, U25.F6, U25.F7, U45.9, U45.10
CAL_PROBE: J2.3, J2.5, J2.7, J2.9
CHIRP_TRIG: J4.19, U1.12, U3.12
CS_ADC0: J4.10, U20.C3
CS_ADC1: J4.11, U21.C3
CS_ADC2: J4.12, U22.C3
CS_ADC3: J4.13, U23.C3
CS_ADC4: J4.14, U24.C3
CS_ADC5: J4.15, U25.C3
CS_BF0: J4.28, U50.27
CS_BF1: J4.29, U51.27
CS_CLK: J4.18, U9.4
CS_PLL_LO: J4.17, U3.15
CS_PLL_TX: J4.16, U1.15
CS_RFIC0: J4.4, U10.19
CS_RFIC1: J4.5, U11.19
CS_RFIC2: J4.6, U12.19
CS_RFIC3: J4.7, U13.19
CS_RFIC4: J4.8, U14.19
CS_RFIC5: J4.9, U15.19
DRAIN_GATE: Q1.4, RG1.2, RG2.1
DRAIN_PD: Q2.3, RG2.2
EN_DRAIN_SW: J4.32, Q2.1, RG3.1
FB_1V0: R37.2, R38.1, U37.4
FPGA_REFCLK: J4.23, U9.42
FPGA_SYSREF: J4.24, U9.43
GND: AE1.2, AE1.3, AE1.4, AE1.5, C1.2, C2.2, C3.2, C4.2, C5.2, C6.2, C7.2, C8.2, C9.2, C10.2, C11.2, C12.2, C30.2, C31.2, C32.2, C33.2, C34.2, C35.2, C37.2, C40.2, C41.2, C42.2, C43.2, C44.2, C45.2, C50.2, C51.2, C52.2, C53.2, C54.2, C55.2, CLF1.2, CLF3.2, H1.1, H2.1, H3.1, H4.1, H5.1, H6.1, H7.1, H8.1, H9.1, H10.1, J1.3, J1.4, J2.1, J2.10, J2.11, J2.12, J2.13, J2.14, J2.15, J2.16, J2.17, J2.18, J2.19, J2.21, J2.22, J2.23, J2.25, J2.27, J2.28, J2.29, J2.31, J2.32, J2.33, J2.34, J2.35, J2.36, J2.37, J2.38, J2.39, J2.40, J2.41, J2.42, J2.43, J2.44, J2.45, J2.46, J2.47, J2.48, J2.49, J2.50, J2.51, J2.52, J2.53, J2.54, J2.55, J2.56, J2.57, J2.58, J2.59, J2.60, J2.61, J2.62, J2.63, J2.64, J2.65, J2.66, J2.67, J2.68, J2.69, J2.70, J2.71, J2.72, J2.73, J2.74, J2.75, J2.76, J2.77, J2.78, J2.79, J2.80, J2.81, J2.82, J2.83, J2.84, J2.85, J2.86, J2.87, J2.88, J2.89, J2.90, J2.91, J2.93, J2.94, J2.95, J2.97, J2.99, J3.1, J3.2, J3.3, J3.6, J3.7, J3.9, J3.12, J3.13, J3.16, J3.18, J3.20, J3.22, J3.24, J3.26, J3.28, J3.30, J3.32, J3.34, J3.36, J3.38, J3.40, J3.42, J3.44, J3.46, J3.48, J3.50, J3.52, J3.54, J3.56, J3.58, J3.59, J3.60, J3.61, J3.62, J3.63, J3.64, J3.65, J3.66, J3.67, J3.68, J3.69, J3.70, J3.71, J3.72, J3.73, J3.74, J3.75, J3.77, J3.78, J3.79, J3.81, J3.83, J3.84, J3.85, J3.87, J3.88, J3.89, J3.90, J3.91, J3.92, J3.93, J3.95, J3.97, J3.99, J4.2, J4.39, J4.40, Q2.2, R10.2, R30.2, R31.2, R32.2, R33.2, R34.2, R35.2, R36.2, R38.2, R100.2, RG3.2, RT1.2, RT2.2, RT3.2, RT4.2, RT5.2, RT6.2, U1.17, U1.25, U2.17, U2.25, U3.17, U3.25, U4.17, U4.25, U5.5, U5.7, U5.13, U5.15, U5.17, U8.5, U8.7, U8.13, U8.15, U8.17, U9.6, U9.7, U9.17, U9.25, U9.65, U10.1, U10.3, U10.5, U10.7, U10.10, U10.12, U10.14, U10.16, U10.21, U10.23, U10.25, U10.30, U10.31, U10.32, U10.33, U10.35, U10.37, U10.39, U10.42, U10.44, U10.46, U10.48, U10.65, U11.1, U11.3, U11.5, U11.7, U11.10, U11.12, U11.14, U11.16, U11.21, U11.23, U11.25, U11.30, U11.31, U11.32, U11.33, U11.35, U11.37, U11.39, U11.42, U11.44, U11.46, U11.48, U11.65, U12.1, U12.3, U12.5, U12.7, U12.10, U12.12, U12.14, U12.16, U12.21, U12.23, U12.25, U12.30, U12.31, U12.32, U12.33, U12.35, U12.37, U12.39, U12.42, U12.44, U12.46, U12.48, U12.65, U13.1, U13.3, U13.5, U13.7, U13.10, U13.12, U13.14, U13.16, U13.21, U13.23, U13.25, U13.30, U13.31, U13.32, U13.33, U13.35, U13.37, U13.39, U13.42, U13.44, U13.46, U13.48, U13.65, U14.1, U14.3, U14.5, U14.7, U14.10, U14.12, U14.14, U14.16, U14.21, U14.23, U14.25, U14.30, U14.31, U14.32, U14.33, U14.35, U14.37, U14.39, U14.42, U14.44, U14.46, U14.48, U14.65, U15.1, U15.3, U15.5, U15.7, U15.10, U15.12, U15.14, U15.16, U15.21, U15.23, U15.25, U15.30, U15.31, U15.32, U15.33, U15.35, U15.37, U15.39, U15.42, U15.44, U15.46, U15.48, U15.65, U20.C4, U20.E1, U20.E2, U20.F2, U20.G5, U20.G6, U20.G7, U20.H5, U20.H6, U21.C4, U21.E1, U21.E2, U21.F2, U21.G5, U21.G6, U21.G7, U21.H5, U21.H6, U22.C4, U22.E1, U22.E2, U22.F2, U22.G5, U22.G6, U22.G7, U22.H5, U22.H6, U23.C4, U23.E1, U23.E2, U23.F2, U23.G5, U23.G6, U23.G7, U23.H5, U23.H6, U24.C4, U24.E1, U24.E2, U24.F2, U24.G5, U24.G6, U24.G7, U24.H5, U24.H6, U25.C4, U25.E1, U25.E2, U25.F2, U25.G5, U25.G6, U25.G7, U25.H5, U25.H6, U30.8, U30.11, U31.8, U31.11, U32.8, U32.11, U33.8, U33.11, U34.8, U34.11, U35.8, U35.11, U36.8, U36.11, U37.5, U37.11, U39.11, U39.15, U39.17, U40.5, U40.11, U41.5, U41.11, U42.5, U42.11, U43.5, U43.11, U44.5, U44.11, U45.5, U45.11, U50.5, U50.7, U50.13, U50.15, U50.28, U50.29, U50.30, U50.32, U50.45, U50.47, U50.49, U51.5, U51.7, U51.13, U51.15, U51.28, U51.29, U51.30, U51.32, U51.45, U51.47, U51.49, U60.2, U60.4, U60.14, U60.16, U60.25, U61.2, U61.4, U61.14, U61.16, U61.25, U62.2, U62.4, U62.14, U62.16, U62.25, U63.2, U63.4, U63.14, U63.16, U63.25, U64.2, U64.4, U64.14, U64.16, U64.25, U65.2, U65.4, U65.14, U65.16, U65.25, U70.2, U70.3, U71.2, U71.3, U72.2, U72.3, U73.2, U73.3, U74.2, U74.3, U75.2, U75.3, Y1.2
GNSS_RF: AE1.1, J4.35
I2C3_SCL: J4.33, U39.9
I2C3_SDA: J4.34, U39.10
ID_PA1: J3.5, J3.23, J3.35, J3.47, U70.6
ID_PA2: J3.11, J3.25, J3.37, J3.49, U71.6
ID_PA3: J3.15, J3.27, J3.39, J3.51, U72.6
ID_PA4: J3.17, J3.29, J3.41, J3.53, U73.6
ID_PA5: J3.19, J3.31, J3.43, J3.55, U74.6
ID_PA6: J3.21, J3.33, J3.45, J3.57, U75.6
IF1_CH1I: U10.49, U20.H11
IF1_CH1Q: U10.50, U20.J11
IF1_CH2I: U10.51, U20.K11
IF1_CH2Q: U10.52, U20.L11
IF1_CH3I: U10.53, U20.L10
IF1_CH3Q: U10.54, U20.L9
IF1_CH4I: U10.55, U20.L8
IF1_CH4Q: U10.56, U20.L7
IF1_CH5I: U10.57, U20.L6
IF1_CH5Q: U10.58, U20.L5
IF1_CH6I: U10.59, U20.L4
IF1_CH6Q: U10.60, U20.L3
IF1_CH7I: U10.61, U20.L2
IF1_CH7Q: U10.62, U20.K1
IF1_CH8I: U10.63, U20.J1
IF1_CH8Q: U10.64, U20.H1
IF2_CH1I: U11.49, U21.H11
IF2_CH1Q: U11.50, U21.J11
IF2_CH2I: U11.51, U21.K11
IF2_CH2Q: U11.52, U21.L11
IF2_CH3I: U11.53, U21.L10
IF2_CH3Q: U11.54, U21.L9
IF2_CH4I: U11.55, U21.L8
IF2_CH4Q: U11.56, U21.L7
IF2_CH5I: U11.57, U21.L6
IF2_CH5Q: U11.58, U21.L5
IF2_CH6I: U11.59, U21.L4
IF2_CH6Q: U11.60, U21.L3
IF2_CH7I: U11.61, U21.L2
IF2_CH7Q: U11.62, U21.K1
IF2_CH8I: U11.63, U21.J1
IF2_CH8Q: U11.64, U21.H1
IF3_CH1I: U12.49, U22.H11
IF3_CH1Q: U12.50, U22.J11
IF3_CH2I: U12.51, U22.K11
IF3_CH2Q: U12.52, U22.L11
IF3_CH3I: U12.53, U22.L10
IF3_CH3Q: U12.54, U22.L9
IF3_CH4I: U12.55, U22.L8
IF3_CH4Q: U12.56, U22.L7
IF3_CH5I: U12.57, U22.L6
IF3_CH5Q: U12.58, U22.L5
IF3_CH6I: U12.59, U22.L4
IF3_CH6Q: U12.60, U22.L3
IF3_CH7I: U12.61, U22.L2
IF3_CH7Q: U12.62, U22.K1
IF3_CH8I: U12.63, U22.J1
IF3_CH8Q: U12.64, U22.H1
IF4_CH1I: U13.49, U23.H11
IF4_CH1Q: U13.50, U23.J11
IF4_CH2I: U13.51, U23.K11
IF4_CH2Q: U13.52, U23.L11
IF4_CH3I: U13.53, U23.L10
IF4_CH3Q: U13.54, U23.L9
IF4_CH4I: U13.55, U23.L8
IF4_CH4Q: U13.56, U23.L7
IF4_CH5I: U13.57, U23.L6
IF4_CH5Q: U13.58, U23.L5
IF4_CH6I: U13.59, U23.L4
IF4_CH6Q: U13.60, U23.L3
IF4_CH7I: U13.61, U23.L2
IF4_CH7Q: U13.62, U23.K1
IF4_CH8I: U13.63, U23.J1
IF4_CH8Q: U13.64, U23.H1
IF5_CH1I: U14.49, U24.H11
IF5_CH1Q: U14.50, U24.J11
IF5_CH2I: U14.51, U24.K11
IF5_CH2Q: U14.52, U24.L11
IF5_CH3I: U14.53, U24.L10
IF5_CH3Q: U14.54, U24.L9
IF5_CH4I: U14.55, U24.L8
IF5_CH4Q: U14.56, U24.L7
IF5_CH5I: U14.57, U24.L6
IF5_CH5Q: U14.58, U24.L5
IF5_CH6I: U14.59, U24.L4
IF5_CH6Q: U14.60, U24.L3
IF5_CH7I: U14.61, U24.L2
IF5_CH7Q: U14.62, U24.K1
IF5_CH8I: U14.63, U24.J1
IF5_CH8Q: U14.64, U24.H1
IF6_CH1I: U15.49, U25.H11
IF6_CH1Q: U15.50, U25.J11
IF6_CH2I: U15.51, U25.K11
IF6_CH2Q: U15.52, U25.L11
IF6_CH3I: U15.53, U25.L10
IF6_CH3Q: U15.54, U25.L9
IF6_CH4I: U15.55, U25.L8
IF6_CH4Q: U15.56, U25.L7
IF6_CH5I: U15.57, U25.L6
IF6_CH5Q: U15.58, U25.L5
IF6_CH6I: U15.59, U25.L4
IF6_CH6Q: U15.60, U25.L3
IF6_CH7I: U15.61, U25.L2
IF6_CH7Q: U15.62, U25.K1
IF6_CH8I: U15.63, U25.J1
IF6_CH8Q: U15.64, U25.H1
JESD1_L0: J2.100, U20.A8
JESD1_L1: J2.98, U20.A7
JESD1_L2: J2.96, U20.A6
JESD1_L3: J2.92, U20.A5
JESD2_L0: J2.30, U21.A8
JESD2_L1: J2.26, U21.A7
JESD2_L2: J2.24, U21.A6
JESD2_L3: J2.20, U21.A5
JESD3_L0: J2.8, U22.A8
JESD3_L1: J2.6, U22.A7
JESD3_L2: J2.4, U22.A6
JESD3_L3: J2.2, U22.A5
JESD4_L0: J3.100, U23.A8
JESD4_L1: J3.98, U23.A7
JESD4_L2: J3.96, U23.A6
JESD4_L3: J3.94, U23.A5
JESD5_L0: J3.86, U24.A8
JESD5_L1: J3.82, U24.A7
JESD5_L2: J3.80, U24.A6
JESD5_L3: J3.76, U24.A5
JESD6_L0: J3.14, U25.A8
JESD6_L1: J3.10, U25.A7
JESD6_L2: J3.8, U25.A6
JESD6_L3: J3.4, U25.A5
JESD_SYNC: J4.20, U20.B1, U21.B1, U22.B1, U23.B1, U24.B1, U25.B1
LO_CHIRP: U5.6, U10.24, U11.24, U12.24, U13.24, U14.24, U15.24
LO_VCO_DIV: U3.9, U4.21
LO_VCO_OUT: U4.9, U5.14
LO_VCO_TUNE: CLF3.1, U3.3, U4.15
MCU_SPI_MISO: J4.27, U50.26, U51.26
MCU_SPI_MOSI: J4.26, U50.25, U51.25
MCU_SPI_SCK: J4.25, U50.24, U51.24
NTC_PA1: RP1.2, RT1.1, U39.1
NTC_PA2: RP2.2, RT2.1, U39.2
NTC_PA3: RP3.2, RT3.1, U39.3
NTC_PA4: RP4.2, RT4.1, U39.4
NTC_PA5: RP5.2, RT5.1, U39.5
NTC_PA6: RP6.2, RT6.1, U39.6
PA_D1: C1.1, C2.1, RS1.2, U60.21, U60.22, U70.5
PA_D2: C3.1, C4.1, RS2.2, U61.21, U61.22, U71.5
PA_D3: C5.1, C6.1, RS3.2, U62.21, U62.22, U72.5
PA_D4: C7.1, C8.1, RS4.2, U63.21, U63.22, U73.5
PA_D5: C9.1, C10.1, RS5.2, U64.21, U64.22, U74.5
PA_D6: C11.1, C12.1, RS6.2, U65.21, U65.22, U75.5
PLL_LD_LO: J4.22, U3.18
PLL_LD_TX: J4.21, U1.18
REF_100M: U1.21, U3.21, U9.1, Y1.3
REF_ADC1: C40.1, U40.8
REF_ADC2: C41.1, U41.8
REF_ADC3: C42.1, U42.8
REF_ADC4: C43.1, U43.8
REF_ADC5: C44.1, U44.8
REF_ADC6: C45.1, U45.8
RF_RESET_N: J4.38, U10.20, U11.20, U12.20, U13.20, U14.20, U15.20
RSET_LO: R100.1, U3.20
RSET_TX: R10.1, U1.20
SET_RF: R36.1, U36.7
SET_RX1: R30.1, U30.7
SET_RX2: R31.1, U31.7
SET_RX3: R32.1, U32.7
SET_RX4: R33.1, U33.7
SET_RX5: R34.1, U34.7
SET_RX6: R35.1, U35.7
SPI_MOSI: J4.3, U1.14, U3.14, U9.5, U10.18, U11.18, U12.18, U13.18, U14.18, U15.18, U20.C2, U21.C2, U22.C2, U23.C2, U24.C2, U25.C2
SPI_SCLK: J4.1, U1.13, U3.13, U9.3, U10.17, U11.17, U12.17, U13.17, U14.17, U15.17, U20.C1, U21.C1, U22.C1, U23.C1, U24.C1, U25.C1
SW_1V0: L1.1, U37.9, U37.10
TXDRV1: U50.14, U60.15
TXDRV2: U51.46, U61.15
TXDRV3: U50.6, U62.15
TXDRV4: U51.6, U63.15
TXDRV5: U50.46, U64.15
TXDRV6: U51.14, U65.15
TX_CHIRP: U8.6, U50.31, U51.31
TX_LOAD: J4.31, U50.34, U51.34
TX_MUTE_N: J4.30, U50.33, U50.37, U51.33, U51.37
TX_VCO_DIV: U1.9, U2.21
TX_VCO_OUT: U2.9, U8.14
TX_VCO_TUNE: CLF1.1, U1.3, U2.15
VCC_RX1: C30.1, U10.4, U10.8, U10.9, U10.13, U10.26, U10.36, U10.40, U10.41, U10.45, U30.9, U30.10
VCC_RX2: C31.1, U11.4, U11.8, U11.9, U11.13, U11.26, U11.36, U11.40, U11.41, U11.45, U31.9, U31.10
VCC_RX3: C32.1, U12.4, U12.8, U12.9, U12.13, U12.26, U12.36, U12.40, U12.41, U12.45, U32.9, U32.10
VCC_RX4: C33.1, U13.4, U13.8, U13.9, U13.13, U13.26, U13.36, U13.40, U13.41, U13.45, U33.9, U33.10
VCC_RX5: C34.1, U14.4, U14.8, U14.9, U14.13, U14.26, U14.36, U14.40, U14.41, U14.45, U34.9, U34.10
VCC_RX6: C35.1, U15.4, U15.8, U15.9, U15.13, U15.26, U15.36, U15.40, U15.41, U15.45, U35.9, U35.10
VCM1: C50.1, U10.27, U20.D1
VCM2: C51.1, U11.27, U21.D1
VCM3: C52.1, U12.27, U22.D1
VCM4: C53.1, U13.27, U23.D1
VCM5: C54.1, U14.27, U24.D1
VCM6: C55.1, U15.27, U25.D1
VG_PA1: U50.20, U60.18
VG_PA2: U51.40, U61.18
VG_PA3: U50.2, U62.18
VG_PA4: U51.2, U63.18
VG_PA5: U50.40, U64.18
VG_PA6: U51.20, U65.18
