ajisrawi/hologuard-hg1-radar/board/kicad/HG1-DSP.kicad_pcb

## KiCad design board/kicad/HG1-DSP.kicad_pcb (2026-10-08)

Schematic: HG1-DSP.kicad_sch, HG-1 processing board

Parts:
C4, C101: 1u; C_0402_1005Metric
C7, C100: 100n; C_0402_1005Metric
C12: 220n; C_0402_1005Metric
C23, C24: 22u; C_0805_2012Metric
C102: 47u; C_0805_2012Metric
CL1, CL2: 470u polymer; C_0805_2012Metric
CR25, CR26, CR27, CR28, CR29: 1u; C_0402_1005Metric
H1, H2, H3, H4, H5, H6: M2.5; MountingHole_2.7mm_M2.5_Pad_Via
J2, J3: LSHM-150 (mate ANT); Samtec_LSHM-150-xx.x-x-DV-N_2x50_P0.50mm_Vertical
J4: LSHM-120 (mate ANT); Samtec_LSHM-120-xx.x-x-DV-N_2x20_P0.50mm_Vertical
J5: FFC to PWR/IO; Hirose_FH12-30S-0.5SH_1x30-1MP_P0.50mm_Horizontal
J6: Micro-Fit +12V in; Molex_Micro-Fit_3.0_43650-0400_1x04_P3.00mm_Horizontal
J7: JTAG; PinHeader_1x06_P1.27mm_Vertical
J8: SWD (Tag-Connect TC2030); PinHeader_1x05_P1.27mm_Vertical
J9: U.FL OTA-cal port; U.FL_Hirose_U.FL-R-SMT-1_Vertical
L1, L2: XAL6030 0.22u; L_Coilcraft_XAL6030-XXX
L3: XAL6030 1.0u; L_Coilcraft_XAL6030-XXX
L23, L24: 2.2u; L_0805_2012Metric
R100: 1M; R_0402_1005Metric
R101: 316k; R_0402_1005Metric
R102: 18.2k; R_0402_1005Metric
R103, R105: 100k; R_0402_1005Metric
R104, R106: 49.9k; R_0402_1005Metric
RD1, RD2: 10k; R_0402_1005Metric
RIO100: 0R (3.3 V to PWR/IO board); R_0402_1005Metric
RN1: 20k 0.1%; R_0402_1005Metric
RN2: 40.2k 0.1%; R_0402_1005Metric
RP1, RP2: 10k 0.1%; R_0402_1005Metric
RPG100: 10k; R_0402_1005Metric
RPOR100: 4.7k; R_0402_1005Metric
RT1, RT2: 10k B3435; R_0402_1005Metric
U1: XCVE2302-1LSESFVA784; Microchip_FCVG784_BGA-784_23x23mm_Layout28x28_P0.8mm
U2, U3: MT53E1G32D2 LPDDR4; BGA-200_10x14.5mm_Layout12x22_P0.8x0.65mm
U4: eMMC 64 GB pSLC; LFBGA-153_11.5x13mm_Layout14x14_P0.5mm
U5: MT25QU512 QSPI; WSON-8-1EP_8x6mm_P1.27mm_EP3.4x4.3mm
U6: DP83867IRRGZ; QFN-48-1EP_7x7mm_P0.5mm_EP5.6x5.6mm
U7: STM32G474RET6; LQFP-64_10x10mm_P0.5mm
U8: NEO-F10T (NEO footprint); ublox_NEO
U9: MDBT50Q nRF52840; Raytac_MDBT50Q
U10: nRF7002; QFN-40-1EP_6x6mm_P0.5mm_EP4.6x4.6mm
U11: ISM330DHCX; Bosch_LGA-14_3x2.5mm_P0.5mm
U12: LIS2MDL; LGA-12_2x2mm_P0.5mm
U20, U21: TPS546D24A 0.8 V; QFN-40-1EP_6x6mm_P0.5mm_EP4.6x4.6mm_ThermalVias
U22: LT8640S 3.3 V; QFN-24-1EP_4x4mm_P0.5mm_EP2.6x2.6mm
U23: TPS62913 1.8 V; DFN-10-1EP_3x3mm_P0.5mm_EP1.65x2.38mm
U24: TPS62913 1.1 V; DFN-10-1EP_3x3mm_P0.5mm_EP1.65x2.38mm
U25: ADP7159 1.5 V LDO; DFN-10-1EP_3x3mm_P0.5mm_EP1.65x2.38mm
U26: ADP7159 0.88 V LDO; DFN-10-1EP_3x3mm_P0.5mm_EP1.65x2.38mm
U27: ADP7159 1.2 V LDO; DFN-10-1EP_3x3mm_P0.5mm_EP1.65x2.38mm
U28: ADP7159 2.5 V LDO; DFN-10-1EP_3x3mm_P0.5mm_EP1.65x2.38mm
U29: ADP7159 1.0 V LDO; DFN-10-1EP_3x3mm_P0.5mm_EP1.65x2.38mm
U30: TPS3700 -5 V window; SOT-23-6
Y2: 33.333 MHz XO (PS_REFCLK); Oscillator_SMD_EuroQuartz_XO53-4Pin_5.0x3.2mm
Y3: 25 MHz XO; Oscillator_SMD_EuroQuartz_XO53-4Pin_5.0x3.2mm

Connections:
+0V88_GT: U1.AH8 (GTYP_AVCC), U26.9 (VOUT), U26.10 (VOUT)
+1V0_PHY: U6.32 (VDD1P0), U6.33 (VDD1P0), U29.9 (VOUT), U29.10 (VOUT)
+1V1_DDR: C24.1, L24.2, R105.1, U1.AH5 (VCCO_DDR), U2.D10 (VDD2), U2.D11 (VDD2), U2.D12 (VDDQ), U2.E1 (VDDQ), U3.D10 (VDD2), U3.D11 (VDD2), U3.D12 (VDDQ), U3.E1 (VDDQ)
+1V2_GT: U1.AH9 (GTYP_AVTT), U27.9 (VOUT), U27.10 (VOUT)
+1V5_AUX: U1.AH4 (VCCAUX), U25.9 (VOUT), U25.10 (VOUT)
+1V8: C23.1, J7.1, L23.2, R103.1, U1.AH6 (VCCO_1V8), U2.D8 (VDD1), U2.D9 (VDD1), U3.D8 (VDD1), U3.D9 (VDD1), U4.A14 (VCCQ), U4.B1 (VCCQ), U5.8 (VCC), U6.34 (VDDIO), U6.35 (VDDIO), U10.12 (VDDIO), U11.5 (VDDIO), U11.8 (VDD), U12.9 (Vdd), U12.10 (Vdd_IO), U26.1 (VIN), U26.2 (VIN), U26.3 (EN), U27.1 (VIN), U27.2 (VIN), U27.3 (EN), U29.1 (VIN), U29.2 (VIN), U29.3 (EN), Y2.1 (EN), Y2.4 (VCC), Y3.1 (EN), Y3.4 (VCC)
+2V5: U6.30 (VDDA2P5), U6.31 (VDDA2P5), U28.9 (VOUT), U28.10 (VOUT)
+3V3: C102.1, J8.1, L3.2, R100.1, RD1.1, RIO100.1, RN1.1, RP1.1, RP2.1, RPG100.1, RPOR100.1, U1.AH7 (VCCO_3V3), U4.A12 (VCC), U4.A13 (VCC), U7.1 (VBAT), U7.16 (VDD), U7.28 (VREF+), U7.29 (VDDA), U7.32 (VDD), U7.48 (VDD), U7.64 (VDD), U8.22 (V_BCKP), U8.23 (VCC), U9.28 (VDD), U9.30 (VDDH), U10.10 (VBAT), U10.11 (VBAT), U25.1 (VIN), U25.2 (VIN), U25.3 (EN), U28.1 (VIN), U28.2 (VIN), U28.3 (EN), U30.5 (VDD)
+3V3_IO: J5.27, RIO100.2
+12V: J6.1, J6.2, U20.1 (VIN), U20.2 (VIN), U20.3 (VIN), U21.1 (VIN), U21.2 (VIN), U21.3 (VIN), U22.1 (VIN), U22.2 (VIN), U23.1 (VIN), U23.2 (VIN), U24.1 (VIN), U24.2 (VIN)
-5V_BIAS: J4.37, J5.25, J5.26, RN2.2
BLE_RX: U1.AG11 (BLE_RX), U9.24 (P0.08)
BLE_TX: U1.AG10 (BLE_TX), U9.22 (P0.06)
BST_3V3: C100.1, U22.13 (BST)
CAL_PROBE: J2.3, J2.5, J2.7, J2.9, J9.1 (In)
CHIRP_TRIG: J4.19, U1.AA18 (CHIRP_TRIG)
CS_ADC0: J4.10, U1.AA9 (CS_ADC0)
CS_ADC1: J4.11, U1.AA10 (CS_ADC1)
CS_ADC2: J4.12, U1.AA11 (CS_ADC2)
CS_ADC3: J4.13, U1.AA12 (CS_ADC3)
CS_ADC4: J4.14, U1.AA13 (CS_ADC4)
CS_ADC5: J4.15, U1.AA14 (CS_ADC5)
CS_BF0: J4.28, U7.18 (PA4)
CS_BF1: J4.29, U7.51 (PA15)
CS_CLK: J4.18, U1.AA17 (CS_CLK)
CS_PLL_LO: J4.17, U1.AA16 (CS_PLL_LO)
CS_PLL_TX: J4.16, U1.AA15 (CS_PLL_TX)
CS_RFIC0: J4.4, U1.AA3 (CS_RFIC0)
CS_RFIC1: J4.5, U1.AA4 (CS_RFIC1)
CS_RFIC2: J4.6, U1.AA5 (CS_RFIC2)
CS_RFIC3: J4.7, U1.AA6 (CS_RFIC3)
CS_RFIC4: J4.8, U1.AA7 (CS_RFIC4)
CS_RFIC5: J4.9, U1.AA8 (CS_RFIC5)
DDRA_CA0: U1.AA22 (DDRA_CA0), U2.A1 (CA0)
DDRA_CA1: U1.AA23 (DDRA_CA1), U2.A2 (CA1)
DDRA_CA2: U1.AA24 (DDRA_CA2), U2.A3 (CA2)
DDRA_CA3: U1.AA25 (DDRA_CA3), U2.A4 (CA3)
DDRA_CA4: U1.AA26 (DDRA_CA4), U2.A5 (CA4)
DDRA_CA5: U1.AA27 (DDRA_CA5), U2.A8 (CA5)
DDRA_CKE: U1.AB1 (DDRA_CKE), U2.A10 (CKE)
DDRA_CK_C: U1.AB3 (DDRA_CK_C), U2.A12 (CK_C)
DDRA_CK_T: U1.AB2 (DDRA_CK_T), U2.A11 (CK_T)
DDRA_CS: U1.AA28 (DDRA_CS), U2.A9 (CS)
DDRA_DMI0: U1.AC17 (DDRA_DMI0), U2.D2 (DMI0)
DDRA_DMI1: U1.AC18 (DDRA_DMI1), U2.D3 (DMI1)
DDRA_DMI2: U1.AC19 (DDRA_DMI2), U2.D4 (DMI2)
DDRA_DMI3: U1.AC20 (DDRA_DMI3), U2.D5 (DMI3)
DDRA_DQ0: U1.AB5 (DDRA_DQ0), U2.AA2 (DQ0)
DDRA_DQ1: U1.AB6 (DDRA_DQ1), U2.AA3 (DQ1)
DDRA_DQ2: U1.AB7 (DDRA_DQ2), U2.AA4 (DQ2)
DDRA_DQ3: U1.AB8 (DDRA_DQ3), U2.AA5 (DQ3)
DDRA_DQ4: U1.AB9 (DDRA_DQ4), U2.AA8 (DQ4)
DDRA_DQ5: U1.AB10 (DDRA_DQ5), U2.AA9 (DQ5)
DDRA_DQ6: U1.AB11 (DDRA_DQ6), U2.AA10 (DQ6)
DDRA_DQ7: U1.AB12 (DDRA_DQ7), U2.AA11 (DQ7)
DDRA_DQ8: U1.AB13 (DDRA_DQ8), U2.AA12 (DQ8)
DDRA_DQ9: U1.AB14 (DDRA_DQ9), U2.AB1 (DQ9)
DDRA_DQ10: U1.AB15 (DDRA_DQ10), U2.AB2 (DQ10)
DDRA_DQ11: U1.AB16 (DDRA_DQ11), U2.AB3 (DQ11)
DDRA_DQ12: U1.AB17 (DDRA_DQ12), U2.AB4 (DQ12)
DDRA_DQ13: U1.AB18 (DDRA_DQ13), U2.AB5 (DQ13)
DDRA_DQ14: U1.AB19 (DDRA_DQ14), U2.AB8 (DQ14)
DDRA_DQ15: U1.AB20 (DDRA_DQ15), U2.AB9 (DQ15)
DDRA_DQ16: U1.AB21 (DDRA_DQ16), U2.AB10 (DQ16)
DDRA_DQ17: U1.AB22 (DDRA_DQ17), U2.AB11 (DQ17)
DDRA_DQ18: U1.AB23 (DDRA_DQ18), U2.AB12 (DQ18)
DDRA_DQ19: U1.AB24 (DDRA_DQ19), U2.B1 (DQ19)
DDRA_DQ20: U1.AB25 (DDRA_DQ20), U2.B2 (DQ20)
DDRA_DQ21: U1.AB26 (DDRA_DQ21), U2.B3 (DQ21)
DDRA_DQ22: U1.AB27 (DDRA_DQ22), U2.B4 (DQ22)
DDRA_DQ23: U1.AB28 (DDRA_DQ23), U2.B5 (DQ23)
DDRA_DQ24: U1.AC1 (DDRA_DQ24), U2.B8 (DQ24)
DDRA_DQ25: U1.AC2 (DDRA_DQ25), U2.B9 (DQ25)
DDRA_DQ26: U1.AC3 (DDRA_DQ26), U2.B10 (DQ26)
DDRA_DQ27: U1.AC4 (DDRA_DQ27), U2.B11 (DQ27)
DDRA_DQ28: U1.AC5 (DDRA_DQ28), U2.B12 (DQ28)
DDRA_DQ29: U1.AC6 (DDRA_DQ29), U2.C1 (DQ29)
DDRA_DQ30: U1.AC7 (DDRA_DQ30), U2.C2 (DQ30)
DDRA_DQ31: U1.AC8 (DDRA_DQ31), U2.C3 (DQ31)
DDRA_DQS_C0: U1.AC13 (DDRA_DQS_C0), U2.C10 (DQS_C0)
DDRA_DQS_C1: U1.AC14 (DDRA_DQS_C1), U2.C11 (DQS_C1)
DDRA_DQS_C2: U1.AC15 (DDRA_DQS_C2), U2.C12 (DQS_C2)
DDRA_DQS_C3: U1.AC16 (DDRA_DQS_C3), U2.D1 (DQS_C3)
DDRA_DQS_T0: U1.AC9 (DDRA_DQS_T0), U2.C4 (DQS_T0)
DDRA_DQS_T1: U1.AC10 (DDRA_DQS_T1), U2.C5 (DQS_T1)
DDRA_DQS_T2: U1.AC11 (DDRA_DQS_T2), U2.C8 (DQS_T2)
DDRA_DQS_T3: U1.AC12 (DDRA_DQS_T3), U2.C9 (DQS_T3)
DDRA_RESET_N: U1.AB4 (DDRA_RESET_N), U2.AA1 (RESET_N)
DDRB_CA0: U1.AC21 (DDRB_CA0), U3.A1 (CA0)
DDRB_CA1: U1.AC22 (DDRB_CA1), U3.A2 (CA1)
DDRB_CA2: U1.AC23 (DDRB_CA2), U3.A3 (CA2)
DDRB_CA3: U1.AC24 (DDRB_CA3), U3.A4 (CA3)
DDRB_CA4: U1.AC25 (DDRB_CA4), U3.A5 (CA4)
DDRB_CA5: U1.AC26 (DDRB_CA5), U3.A8 (CA5)
DDRB_CKE: U1.AC28 (DDRB_CKE), U3.A10 (CKE)
DDRB_CK_C: U1.AD2 (DDRB_CK_C), U3.A12 (CK_C)
DDRB_CK_T: U1.AD1 (DDRB_CK_T), U3.A11 (CK_T)
DDRB_CS: U1.AC27 (DDRB_CS), U3.A9 (CS)
DDRB_DMI0: U1.AE16 (DDRB_DMI0), U3.D2 (DMI0)
DDRB_DMI1: U1.AE17 (DDRB_DMI1), U3.D3 (DMI1)
DDRB_DMI2: U1.AE18 (DDRB_DMI2), U3.D4 (DMI2)
DDRB_DMI3: U1.AE19 (DDRB_DMI3), U3.D5 (DMI3)
DDRB_DQ0: U1.AD4 (DDRB_DQ0), U3.AA2 (DQ0)
DDRB_DQ1: U1.AD5 (DDRB_DQ1), U3.AA3 (DQ1)
DDRB_DQ2: U1.AD6 (DDRB_DQ2), U3.AA4 (DQ2)
DDRB_DQ3: U1.AD7 (DDRB_DQ3), U3.AA5 (DQ3)
DDRB_DQ4: U1.AD8 (DDRB_DQ4), U3.AA8 (DQ4)
DDRB_DQ5: U1.AD9 (DDRB_DQ5), U3.AA9 (DQ5)
DDRB_DQ6: U1.AD10 (DDRB_DQ6), U3.AA10 (DQ6)
DDRB_DQ7: U1.AD11 (DDRB_DQ7), U3.AA11 (DQ7)
DDRB_DQ8: U1.AD12 (DDRB_DQ8), U3.AA12 (DQ8)
DDRB_DQ9: U1.AD13 (DDRB_DQ9), U3.AB1 (DQ9)
DDRB_DQ10: U1.AD14 (DDRB_DQ10), U3.AB2 (DQ10)
DDRB_DQ11: U1.AD15 (DDRB_DQ11), U3.AB3 (DQ11)
DDRB_DQ12: U1.AD16 (DDRB_DQ12), U3.AB4 (DQ12)
DDRB_DQ13: U1.AD17 (DDRB_DQ13), U3.AB5 (DQ13)
DDRB_DQ14: U1.AD18 (DDRB_DQ14), U3.AB8 (DQ14)
DDRB_DQ15: U1.AD19 (DDRB_DQ15), U3.AB9 (DQ15)
DDRB_DQ16: U1.AD20 (DDRB_DQ16), U3.AB10 (DQ16)
DDRB_DQ17: U1.AD21 (DDRB_DQ17), U3.AB11 (DQ17)
DDRB_DQ18: U1.AD22 (DDRB_DQ18), U3.AB12 (DQ18)
DDRB_DQ19: U1.AD23 (DDRB_DQ19), U3.B1 (DQ19)
DDRB_DQ20: U1.AD24 (DDRB_DQ20), U3.B2 (DQ20)
DDRB_DQ21: U1.AD25 (DDRB_DQ21), U3.B3 (DQ21)
DDRB_DQ22: U1.AD26 (DDRB_DQ22), U3.B4 (DQ22)
DDRB_DQ23: U1.AD27 (DDRB_DQ23), U3.B5 (DQ23)
DDRB_DQ24: U1.AD28 (DDRB_DQ24), U3.B8 (DQ24)
DDRB_DQ25: U1.AE1 (DDRB_DQ25), U3.B9 (DQ25)
DDRB_DQ26: U1.AE2 (DDRB_DQ26), U3.B10 (DQ26)
DDRB_DQ27: U1.AE3 (DDRB_DQ27), U3.B11 (DQ27)
DDRB_DQ28: U1.AE4 (DDRB_DQ28), U3.B12 (DQ28)
DDRB_DQ29: U1.AE5 (DDRB_DQ29), U3.C1 (DQ29)
DDRB_DQ30: U1.AE6 (DDRB_DQ30), U3.C2 (DQ30)
DDRB_DQ31: U1.AE7 (DDRB_DQ31), U3.C3 (DQ31)
DDRB_DQS_C0: U1.AE12 (DDRB_DQS_C0), U3.C10 (DQS_C0)
DDRB_DQS_C1: U1.AE13 (DDRB_DQS_C1), U3.C11 (DQS_C1)
DDRB_DQS_C2: U1.AE14 (DDRB_DQS_C2), U3.C12 (DQS_C2)
DDRB_DQS_C3: U1.AE15 (DDRB_DQS_C3), U3.D1 (DQS_C3)
DDRB_DQS_T0: U1.AE8 (DDRB_DQS_T0), U3.C4 (DQS_T0)
DDRB_DQS_T1: U1.AE9 (DDRB_DQS_T1), U3.C5 (DQS_T1)
DDRB_DQS_T2: U1.AE10 (DDRB_DQS_T2), U3.C8 (DQS_T2)
DDRB_DQS_T3: U1.AE11 (DDRB_DQS_T3), U3.C9 (DQS_T3)
DDRB_RESET_N: U1.AD3 (DDRB_RESET_N), U3.AA1 (RESET_N)
DISC_IN: J5.17, U1.AG22 (DISC_IN)
EMMC_CLK: U1.AE20 (EMMC_CLK), U4.A1 (CLK)
EMMC_CMD: U1.AE21 (EMMC_CMD), U4.A2 (CMD)
EMMC_D0: U1.AE22 (EMMC_D0), U4.A4 (DAT0)
EMMC_D1: U1.AE23 (EMMC_D1), U4.A5 (DAT1)
EMMC_D2: U1.AE24 (EMMC_D2), U4.A6 (DAT2)
EMMC_D3: U1.AE25 (EMMC_D3), U4.A7 (DAT3)
EMMC_D4: U1.AE26 (EMMC_D4), U4.A8 (DAT4)
EMMC_D5: U1.AE27 (EMMC_D5), U4.A9 (DAT5)
EMMC_D6: U1.AE28 (EMMC_D6), U4.A10 (DAT6)
EMMC_D7: U1.AF1 (EMMC_D7), U4.A11 (DAT7)
EMMC_RST_N: U1.AF2 (EMMC_RST_N), U4.A3 (RST_N)
EMMC_VDDI: C4.1, U4.B2 (VDDI)
EN_28V: J5.18, U7.58 (PB5)
EN_DRAIN_SW: J4.32, U7.42 (PA8)
EN_HEATER: J5.21, U7.39 (PC7)
EN_NEG5: J5.19, U7.57 (PB4)
EN_RF_5V: J5.20, U7.60 (PB7)
EN_VERSAL: U7.38 (PC6), U20.4 (EN), U21.4 (EN), U22.3 (EN/UV), U23.3 (EN), U24.3 (EN)
FB_3V3: R100.2, R101.1, U22.4 (FB)
FB_U23: R103.2, R104.1, U23.4 (FB)
FB_U24: R105.2, R106.1, U24.4 (FB)
FPGA_REFCLK: J4.23, U1.A25 (GTREFCLK)
FPGA_SYSREF: J4.24, U1.A26 (SYSREF_IN)
GND: C4.2, C7.2, C12.2, C23.2, C24.2, C101.2, C102.2, CL1.2, CL2.2, CR25.2, CR26.2, CR27.2, CR28.2, CR29.2, H1.1, H2.1, H3.1, H4.1, H5.1, H6.1, J2.1, J2.10, J2.11, J2.12, J2.13, J2.14, J2.15, J2.16, J2.17, J2.18, J2.19, J2.21, J2.22, J2.23, J2.25, J2.27, J2.28, J2.29, J2.31, J2.32, J2.33, J2.34, J2.35, J2.36, J2.37, J2.38, J2.39, J2.40, J2.41, J2.42, J2.43, J2.44, J2.45, J2.46, J2.47, J2.48, J2.49, J2.50, J2.51, J2.52, J2.53, J2.54, J2.55, J2.56, J2.57, J2.58, J2.59, J2.60, J2.61, J2.62, J2.63, J2.64, J2.65, J2.66, J2.67, J2.68, J2.69, J2.70, J2.71, J2.72, J2.73, J2.74, J2.75, J2.76, J2.77, J2.78, J2.79, J2.80, J2.81, J2.82, J2.83, J2.84, J2.85, J2.86, J2.87, J2.88, J2.89, J2.90, J2.91, J2.93, J2.94, J2.95, J2.97, J2.99, J3.1, J3.2, J3.3, J3.6, J3.7, J3.9, J3.12, J3.13, J3.16, J3.18, J3.20, J3.22, J3.24, J3.26, J3.28, J3.30, J3.32, J3.34, J3.36, J3.38, J3.40, J3.42, J3.44, J3.46, J3.48, J3.50, J3.52, J3.54, J3.56, J3.58, J3.59, J3.60, J3.61, J3.62, J3.63, J3.64, J3.65, J3.66, J3.67, J3.68, J3.69, J3.70, J3.71, J3.72, J3.73, J3.74, J3.75, J3.77, J3.78, J3.79, J3.81, J3.83, J3.84, J3.85, J3.87, J3.88, J3.89, J3.90, J3.91, J3.92, J3.93, J3.95, J3.97, J3.99, J4.2, J4.39, J4.40, J5.3, J5.6, J5.9, J5.12, J5.28, J5.29, J5.30, J6.3, J6.4, J7.6, J8.5, J9.2 (Ext), R101.2, R102.2, R104.2, R106.2, RD2.2, RT1.2, RT2.2, U1.AH10 (GND), U2.E2 (VSS), U2.E3 (VSS), U2.E4 (VSS), U3.E2 (VSS), U3.E3 (VSS), U3.E4 (VSS), U4.B3 (VSS), U4.B4 (VSS), U5.4 (VSS), U5.9 (PAD), U6.36 (GND), U6.49 (GND), U7.15 (VSS), U7.27 (VSSA), U7.31 (VSS), U7.47 (VSS), U7.63 (VSS), U8.7 (VDD_USB), U8.10 (GND), U8.12 (GND), U8.13 (GND), U8.24 (GND), U9.1 (GND), U9.2 (GND), U9.15 (GND), U9.33 (GND), U9.55 (GND), U10.19 (GND), U10.21 (GND), U10.41 (GND), U11.6 (GND), U11.7 (GND), U12.6 (GND), U12.8 (GND), U20.8 (VOSNS-), U20.24 (ADRSEL), U20.30 (GND), U20.41 (GND), U21.8 (VOSNS-), U21.24 (ADRSEL), U21.30 (GND), U21.41 (GND), U22.17 (GND), U22.25 (GND), U23.5 (GND), U23.11 (GND), U24.5 (GND), U24.11 (GND), U25.5 (GND), U25.11 (GND), U26.5 (GND), U26.11 (GND), U27.5 (GND), U27.11 (GND), U28.5 (GND), U28.11 (GND), U29.5 (GND), U29.11 (GND), U30.2 (GND), Y2.2 (GND), Y3.2 (GND)
GNSS_RF: J4.35, U8.11 (RF_IN)
GNSS_RX: U1.AG1 (GNSS_RX), U8.21 (RXD/SPI_MOSI)
GNSS_TX: U1.AG2 (GNSS_TX), U8.20 (TXD/SPI_MISO)
I2C3_SCL: J4.33, U1.AF27 (PMB_SCL), U7.40 (PC8), U20.5 (PMB_CLK), U21.5 (PMB_CLK)
I2C3_SDA: J4.34, U1.AF28 (PMB_SDA), U7.41 (PC9), U20.6 (PMB_DATA), U21.6 (PMB_DATA)
ID_PA1: J3.5, J3.23, J3.35, J3.47, U7.9 (PC1)
ID_PA2: J3.11, J3.25, J3.37, J3.49, U7.10 (PC2)
ID_PA3: J3.15, J3.27, J3.39, J3.51, U7.11 (PC3)
ID_PA4: J3.17, J3.29, J3.41, J3.53, U7.36 (PB14)
ID_PA5: J3.19, J3.31, J3.43, J3.55, U7.5 (PF0)
ID_PA6: J3.21, J3.33, J3.45, J3.57, U7.34 (PB12)
IMU_CS: U1.AG7 (IMU_CS), U11.12 (CS)
IMU_INT: U1.AG9 (IMU_INT), U11.4 (INT1)
IMU_MISO: U1.AG6 (IMU_MISO), U11.1 (SDO/SA0)
IMU_MOSI: U1.AG5 (IMU_MOSI), U11.14 (SDA), U12.4 (SDA/SDI/SDO)
IMU_SCLK: U1.AG4 (IMU_SCLK), U11.13 (SCL), U12.1 (SCL/SPC)
INTVCC_3V3: C101.1, U22.14 (INTVCC)
JESD1_L0: J2.100, U1.A1 (GTYP_RX_1_0)
JESD1_L1: J2.98, U1.A2 (GTYP_RX_1_1)
JESD1_L2: J2.96, U1.A3 (GTYP_RX_1_2)
JESD1_L3: J2.92, U1.A4 (GTYP_RX_1_3)
JESD2_L0: J2.30, U1.A5 (GTYP_RX_2_0)
JESD2_L1: J2.26, U1.A6 (GTYP_RX_2_1)
JESD2_L2: J2.24, U1.A7 (GTYP_RX_2_2)
JESD2_L3: J2.20, U1.A8 (GTYP_RX_2_3)
JESD3_L0: J2.8, U1.A9 (GTYP_RX_3_0)
JESD3_L1: J2.6, U1.A10 (GTYP_RX_3_1)
JESD3_L2: J2.4, U1.A11 (GTYP_RX_3_2)
JESD3_L3: J2.2, U1.A12 (GTYP_RX_3_3)
JESD4_L0: J3.100, U1.A13 (GTYP_RX_4_0)
JESD4_L1: J3.98, U1.A14 (GTYP_RX_4_1)
JESD4_L2: J3.96, U1.A15 (GTYP_RX_4_2)
JESD4_L3: J3.94, U1.A16 (GTYP_RX_4_3)
JESD5_L0: J3.86, U1.A17 (GTYP_RX_5_0)
JESD5_L1: J3.82, U1.A18 (GTYP_RX_5_1)
JESD5_L2: J3.80, U1.A19 (GTYP_RX_5_2)
JESD5_L3: J3.76, U1.A20 (GTYP_RX_5_3)
JESD6_L0: J3.14, U1.A21 (GTYP_RX_6_0)
JESD6_L1: J3.10, U1.A22 (GTYP_RX_6_1)
JESD6_L2: J3.8, U1.A23 (GTYP_RX_6_2)
JESD6_L3: J3.4, U1.A24 (GTYP_RX_6_3)
JESD_SYNC: J4.20, U1.A27 (JESD_SYNC)
JTAG_TCK: J7.2, U1.AG24 (TCK)
JTAG_TDI: J7.4, U1.AG26 (TDI)
JTAG_TDO: J7.5, U1.AG27 (TDO)
JTAG_TMS: J7.3, U1.AG25 (TMS)
MAG_C1: C12.1, U12.5 (C1)
MAG_CS: U1.AG8 (MAG_CS), U12.3 (~CS)
MCU_SPI_MISO: J4.27, U7.20 (PA6)
MCU_SPI_MOSI: J4.26, U7.21 (PA7)
MCU_SPI_SCK: J4.25, U7.19 (PA5)
MDC: U1.AF15 (MDC), U6.13 (MDC)
MDIO: U1.AF24 (MDIO), U6.14 (MDIO)
NEG_PGOOD: RPG100.2, U7.54 (PC12), U30.1 (OUTA), U30.6 (OUTB)
NRST: C7.1, J8.4, U7.7 (PG10)
NTC_HOUSING: RP1.2, RT1.1, U7.33 (PB11)
NTC_RFIC: RP2.2, RT2.1, U7.24 (PB0)
PHY_INT_N: U1.AF23 (PHY_INT_N), U6.16 (INT_N)
PHY_MD1: J5.1, U6.17 (TD_A+)
PHY_MD2: J5.2, U6.18 (TD_A-)
PHY_MD3: J5.4, U6.19 (TD_B+)
PHY_MD4: J5.5, U6.20 (TD_B-)
PHY_MD5: J5.7, U6.21 (TD_C+)
PHY_MD6: J5.8, U6.22 (TD_C-)
PHY_MD7: J5.10, U6.23 (TD_D+)
PHY_MD8: J5.11, U6.24 (TD_D-)
PHY_RST_N: U1.AF16 (PHY_RST_N), U6.15 (RESET_N)
PHY_XI: U6.26 (XI), Y3.3 (OUT)
PLL_LD_LO: J4.22, U1.AA21 (PLL_LD_LO), U7.53 (PC11)
PLL_LD_TX: J4.21, U1.AA20 (PLL_LD_TX), U7.52 (PC10)
POR_B: RPOR100.2, U1.AG28 (POR_B), U20.23 (PGOOD), U21.23 (PGOOD)
PPS: U1.AG3 (PPS), U8.3 (TIMEPULSE)
PPS_EXT: J5.16, U1.AG21 (PPS_EXT)
PS_REFCLK: U1.AH1 (PS_REFCLK), Y2.3 (OUT)
QSPI_CLK: U1.AF3 (QSPI_CLK), U5.6 (C)
QSPI_CS_N: U1.AF4 (QSPI_CS_N), U5.1 (~S)
QSPI_DQ0: U1.AF5 (QSPI_DQ0), U5.5 (DQ0)
QSPI_DQ1: U1.AF6 (QSPI_DQ1), U5.2 (DQ1)
QSPI_DQ2: U1.AF7 (QSPI_DQ2), U5.3 (~W/DQ2)
QSPI_DQ3: U1.AF8 (QSPI_DQ3), U5.7 (~RESET/DQ3)
REF_U25: CR25.1, U25.8 (REF)
REF_U26: CR26.1, U26.8 (REF)
REF_U27: CR27.1, U27.8 (REF)
REF_U28: CR28.1, U28.8 (REF)
REF_U29: CR29.1, U29.8 (REF)
RF_RESET_N: J4.38, U1.AG23 (RF_RESET_N)
RGMII_RXC: U1.AF17 (RGMII_RXC), U6.7 (RX_CLK)
RGMII_RXD0: U1.AF19 (RGMII_RXD0), U6.9 (RX_D0)
RGMII_RXD1: U1.AF20 (RGMII_RXD1), U6.10 (RX_D1)
RGMII_RXD2: U1.AF21 (RGMII_RXD2), U6.11 (RX_D2)
RGMII_RXD3: U1.AF22 (RGMII_RXD3), U6.12 (RX_D3)
RGMII_RX_CTL: U1.AF18 (RGMII_RX_CTL), U6.8 (RX_CTRL)
RGMII_TXC: U1.AF9 (RGMII_TXC), U6.1 (TX_CLK)
RGMII_TXD0: U1.AF11 (RGMII_TXD0), U6.3 (TX_D0)
RGMII_TXD1: U1.AF12 (RGMII_TXD1), U6.4 (TX_D1)
RGMII_TXD2: U1.AF13 (RGMII_TXD2), U6.5 (TX_D2)
RGMII_TXD3: U1.AF14 (RGMII_TXD3), U6.6 (TX_D3)
RGMII_TX_CTL: U1.AF10 (RGMII_TX_CTL), U6.2 (TX_CTRL)
RID_RF: J4.36, U10.20 (RF)
RS485_DE: J5.15, U1.AG20 (RS485_DE)
RS485_RX: J5.14, U1.AG19 (RS485_RX)
RS485_TX: J5.13, U1.AG18 (RS485_TX)
RT_3V3: R102.1, U22.5 (RT)
SPI_MOSI: J4.3, U1.AA1 (SPI_MOSI)
SPI_SCLK: J4.1, U1.A28 (SPI_SCLK)
SWCLK: J8.3, U7.50 (PA14)
SWDIO: J8.2, U7.49 (PA13)
SW_3V3: C100.2, L3.1, U22.10 (SW), U22.11 (SW)
SW_AIE: L2.1, U21.20 (SW), U21.21 (SW), U21.22 (SW)
SW_U23: L23.1, U23.9 (SW), U23.10 (SW)
SW_U24: L24.1, U24.9 (SW), U24.10 (SW)
SW_VCCINT: L1.1, U20.20 (SW), U20.21 (SW), U20.22 (SW)
TX_LOAD: J4.31, U1.AA19 (TX_LOAD)
TX_MUTE_N: J4.30, U7.59 (PB6)
UART_M2V: U1.AF26 (UART_MCU_RX), U7.43 (PA9)
UART_V2M: U1.AF25 (UART_MCU_TX), U7.44 (PA10)
V3V3_SENSE: RD1.2, RD2.1, U7.17 (PA3)
V5_SENSE: J5.24, U7.14 (PA2)
V28_SENSE: J5.23, U7.13 (PA1)
VCCINT_0V8: CL1.1, L1.2, U1.AH2 (VCCINT), U20.7 (VOSNS+)
VCC_AIE_0V8: CL2.1, L2.2, U1.AH3 (VCC_AIE), U21.7 (VOSNS+)
VIN_SENSE: J5.22, U7.12 (PA0)
VNEG_SENSE: RN1.2, RN2.1, U7.8 (PC0), U7.25 (PB1), U30.3 (INA+), U30.4 (INB-)
WIFI_CS: U1.AG15 (WIFI_CS), U10.4 (SPI_CS)
WIFI_EN: U1.AG17 (WIFI_EN), U10.6 (BUCKEN), U10.7 (IOVDD_EN)
WIFI_IRQ: U1.AG16 (WIFI_IRQ), U10.5 (HOST_IRQ)
WIFI_MISO: U1.AG14 (WIFI_MISO), U10.3 (SPI_MISO)
WIFI_MOSI: U1.AG13 (WIFI_MOSI), U10.2 (SPI_MOSI)
WIFI_SCK: U1.AG12 (WIFI_SCK), U10.1 (SPI_SCK)

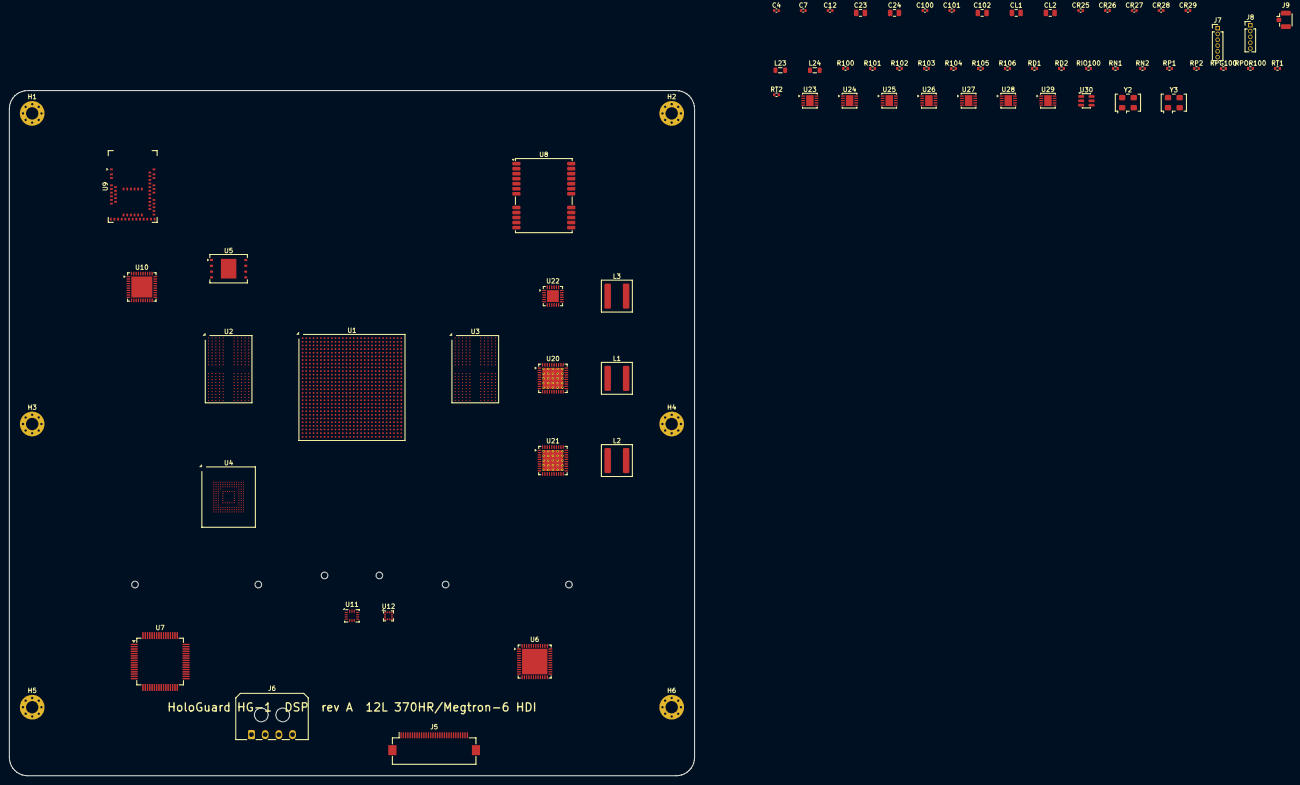
[picture p58: board HG1-DSP.kicad_pcb from above]

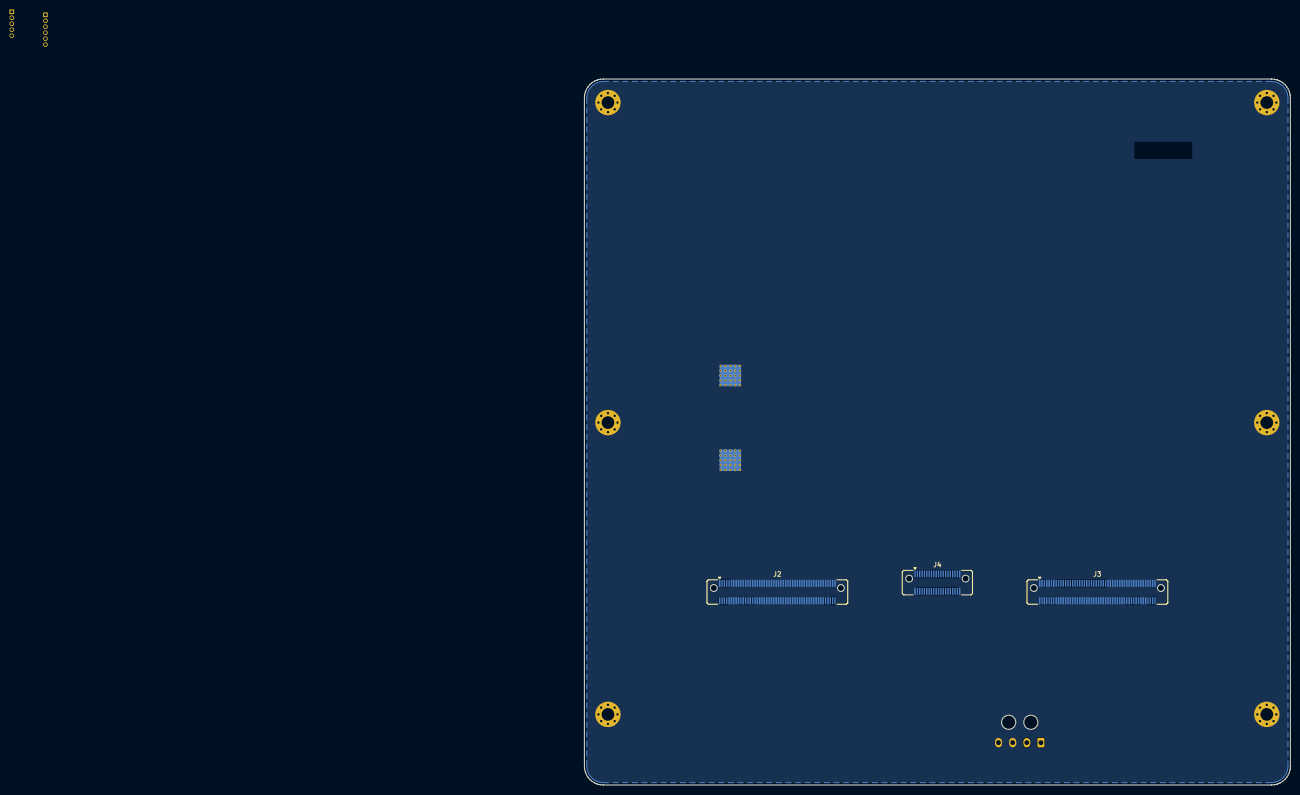
[picture p59: board HG1-DSP.kicad_pcb from below]

Board: 12 copper layers, 150.0 x 150.0 mm, 77 parts (3 on the bottom side), 297 nets, no tracks yet.
