ajisrawi/hologuard-hg1-radar/board/kicad/HG1-PWR.kicad_pcb

## KiCad design board/kicad/HG1-PWR.kicad_pcb (2026-10-08)

Schematic: HG1-PWR.kicad_sch, HG-1 power / IO board

Parts:
C1: 100u 50V hold-up; CP_Elec_8x10
C2: 100u 50V; CP_Elec_8x10
C100: 47n; C_0402_1005Metric
C101, C104: 100n; C_0402_1005Metric
C102, C105: 1u; C_0402_1005Metric
C103: 47u; C_0805_2012Metric
C106, C108: 4.7u; C_0402_1005Metric
C107: 10u 50V; C_1210_3225Metric
CCH100: 10n 2kV; C_0805_2012Metric
D1: SMCJ36CA; D_SMC
H1, H2, H3, H4: M3; MountingHole_3.2mm_M3_Pad_Via
J1: M12 A-coded 8p power/IO; M12_8P_PCB
J2: M12 X-coded Ethernet; M12_8P_PCB
J3: Micro-Fit to ANT; Molex_Micro-Fit_3.0_43650-0400_1x04_P3.00mm_Horizontal
J4: Micro-Fit to DSP; Molex_Micro-Fit_3.0_43650-0400_1x04_P3.00mm_Horizontal
J5: FFC to DSP; Hirose_FH12-30S-0.5SH_1x30-1MP_P0.50mm_Horizontal
J6: Radome / board heater 10 W; JST_PH_B2B-PH-K_1x02_P2.00mm_Vertical
L1: DM filter 4.7u; L_12x12mm_H6mm
L2: XAL6030 4.7u; L_Coilcraft_XAL6030-XXX
L3: 10u 6A; L_12x12mm_H6mm
L4: 10u; L_0805_2012Metric
L5: XAL6030 2.2u; L_Coilcraft_XAL6030-XXX
Q1: N-MOSFET 80 V pass FET; SOIC-8_3.9x4.9mm_P1.27mm
Q2, Q3, Q4, Q5: N-MOSFET 60 V; SOIC-8_3.9x4.9mm_P1.27mm
Q6: N-MOSFET heater switch; SOIC-8_3.9x4.9mm_P1.27mm
R100, R102, R104, R116: 100k; R_0402_1005Metric
R101: 10k; R_0402_1005Metric
R103: 2.7k; R_0402_1005Metric
R105: 3.3k; R_0402_1005Metric
R106, R109, R113: 1M; R_0402_1005Metric
R107: 73.2k; R_0402_1005Metric
R108, R111: 18.2k; R_0402_1005Metric
R110: 191k; R_0402_1005Metric
R112: 4m 1%; R_0402_1005Metric
R114: 35.7k; R_0402_1005Metric
R115: 402k; R_0402_1005Metric
RCH100: 1M; R_0402_1005Metric
RHT100: 100k; R_0402_1005Metric
RS1: 5m 1%; R_0402_1005Metric
RV1: 150k; R_0402_1005Metric
RV2, RV4, RV5, RV6: 10k; R_0402_1005Metric
RV3: 100k; R_0402_1005Metric
T1: HX1188NL; GBE_MAG_16P
U1: LT4363; DFN-10-1EP_3x3mm_P0.5mm_EP1.65x2.38mm
U2: LT8640S 12 V; QFN-24-1EP_4x4mm_P0.5mm_EP2.6x2.6mm
U3: LT8390 28 V buck-boost; QFN-28-1EP_4x5mm_P0.5mm_EP2.65x3.65mm
U4: LT3462 -5 V; TSOT-23-6
U5: LT8640S 5 V; QFN-24-1EP_4x4mm_P0.5mm_EP2.6x2.6mm
U6: THVD1450; SOIC-8_3.9x4.9mm_P1.27mm

Connections:
+3V3_IO: J5.27, U6.8 (VCC)
+5V_RF: C2.1, J3.2, L4.1, L5.2, R109.1, RV5.1, U4.5 (VIN)
+12V_DSP: C103.1, J4.1, J4.2, L2.2, R106.1
+28V_PA: C107.1, J3.1, R112.2, R113.1, RV3.1, U3.6 (ISN)
-5V_BIAS: C108.1, J5.25, J5.26, R115.1, U4.6 (VOUT)
BG1: Q3.4 (G), U3.21 (BG1)
BG2: Q5.4 (G), U3.23 (BG2)
BST_5: C104.1, U5.13 (BST)
BST_12: C101.1, U2.13 (BST)
CHASSIS: CCH100.1, J1.S1 (SHELL), J1.S2 (SHELL), J1.S3 (SHELL), J1.S4 (SHELL), J2.S1 (SHELL), J2.S2 (SHELL), J2.S3 (SHELL), J2.S4 (SHELL), RCH100.1
DISC_IN: J1.8, J5.17
EN_28V: J5.18, U3.3 (EN/UVLO)
EN_HEATER: J5.21, Q6.4 (G), RHT100.1
EN_NEG5: J5.19, U4.4 (SHDN)
EN_RF_5V: J5.20, U5.3 (EN/UV)
FB_5: R109.2, R110.1, U5.4 (FB)
FB_12: R106.2, R107.1, U2.4 (FB)
FB_28: R113.2, R114.1, U3.4 (FB)
FB_NEG: R115.2, R116.1, U4.3 (FB)
FB_SURGE: R104.2, R105.1, U1.8 (FB)
GND: C1.2, C2.2, C100.2, C102.2, C103.2, C105.2, C106.2, C107.2, C108.2, CCH100.2, D1.2 (A2), H1.1, H2.1, H3.1, H4.1, J1.3, J1.4, J3.3, J3.4, J4.3, J4.4, J5.3, J5.6, J5.9, J5.12, J5.28, J5.29, J5.30, Q3.1 (S), Q3.2 (S), Q3.3 (S), Q5.1 (S), Q5.2 (S), Q5.3 (S), Q6.1 (S), Q6.2 (S), Q6.3 (S), R101.2, R103.2, R105.2, R107.2, R108.2, R110.2, R111.2, R114.2, R116.2, RCH100.2, RHT100.2, RV2.2, RV4.2, RV6.2, U1.5 (GND), U1.11 (GND), U2.17 (GND), U2.25 (GND), U3.13 (GND), U3.29 (GND), U4.2 (GND), U5.17 (GND), U5.25 (GND), U6.2 (~RE), U6.5 (GND)
HEATER_N: J6.2, Q6.5 (D), Q6.6 (D), Q6.7 (D), Q6.8 (D)
INTVCC_5: C105.1, U5.14 (INTVCC)
INTVCC_12: C102.1, U2.14 (INTVCC)
INTVCC_28: C106.1, U3.27 (INTVCC)
ISP_28: Q4.5 (D), Q4.6 (D), Q4.7 (D), Q4.8 (D), R112.1, U3.5 (ISP)
MDI_1: J2.1, T1.9 (CA+)
MDI_2: J2.2, T1.10 (CA-)
MDI_3: J2.3, T1.11 (CB+)
MDI_4: J2.4, T1.12 (CB-)
MDI_5: J2.5, T1.13 (CC+)
MDI_6: J2.6, T1.14 (CC-)
MDI_7: J2.7, T1.15 (CD+)
MDI_8: J2.8, T1.16 (CD-)
OV_DIV: R102.2, R103.1, U1.4 (OV)
PHY_MD1: J5.1, T1.1 (PA+)
PHY_MD2: J5.2, T1.2 (PA-)
PHY_MD3: J5.4, T1.3 (PB+)
PHY_MD4: J5.5, T1.4 (PB-)
PHY_MD5: J5.7, T1.5 (PC+)
PHY_MD6: J5.8, T1.6 (PC-)
PHY_MD7: J5.10, T1.7 (PD+)
PHY_MD8: J5.11, T1.8 (PD-)
PPS_EXT: J1.7, J5.16
RS485_A: J1.5, U6.6 (A)
RS485_B: J1.6, U6.7 (B)
RS485_DE: J5.15, U6.3 (DE)
RS485_RX: J5.14, U6.1 (R)
RS485_TX: J5.13, U6.4 (D)
RT_5: R111.1, U5.5 (RT)
RT_12: R108.1, U2.5 (RT)
SURGE_GATE: Q1.4 (G), U1.6 (GATE)
SW1_28: L3.1, Q2.1 (S), Q2.2 (S), Q2.3 (S), Q3.5 (D), Q3.6 (D), Q3.7 (D), Q3.8 (D), U3.24 (SW1)
SW2_28: L3.2, Q4.1 (S), Q4.2 (S), Q4.3 (S), Q5.5 (D), Q5.6 (D), Q5.7 (D), Q5.8 (D), U3.25 (SW2)
SW_5: C104.2, L5.1, U5.10 (SW), U5.11 (SW)
SW_12: C101.2, L2.1, U2.10 (SW), U2.11 (SW)
SW_NEG: L4.2, U4.1 (SW)
TG1: Q2.4 (G), U3.20 (TG1)
TG2: Q4.4 (G), U3.22 (TG2)
TMR: C100.1, U1.9 (TMR)
UV_DIV: R100.2, R101.1, U1.3 (UV)
V5_SENSE: J5.24, RV5.2, RV6.1
V28_SENSE: J5.23, RV3.2, RV4.1
VIN_FILT: C1.1, J6.1, L1.2, Q2.5 (D), Q2.6 (D), Q2.7 (D), Q2.8 (D), U2.1 (VIN), U2.2 (VIN), U2.3 (EN/UV), U3.1 (VIN), U3.2 (VIN), U5.1 (VIN), U5.2 (VIN)
VIN_PROT: L1.1, R104.1, RS1.2, RV1.1, U1.7 (OUT)
VIN_RAW: D1.1 (A1), J1.1, J1.2, Q1.5 (D), Q1.6 (D), Q1.7 (D), Q1.8 (D), R100.1, R102.1, U1.1 (VCC)
VIN_SENSE: J5.22, RV1.2, RV2.1
VIN_SNS: Q1.1 (S), Q1.2 (S), Q1.3 (S), RS1.1, U1.2 (SNS)

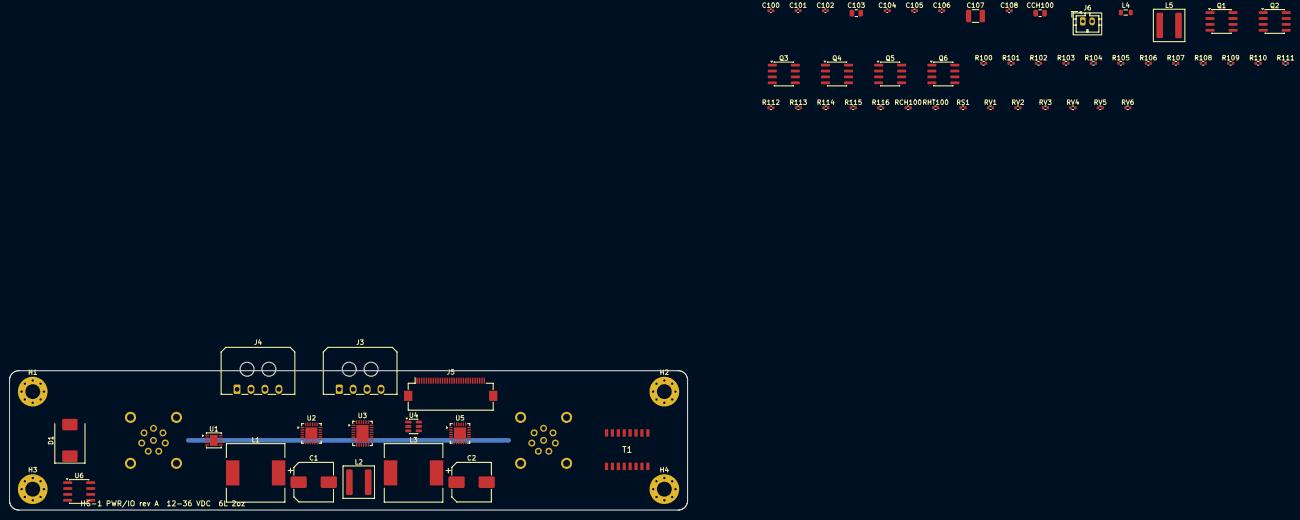
[picture p60: board HG1-PWR.kicad_pcb from above]

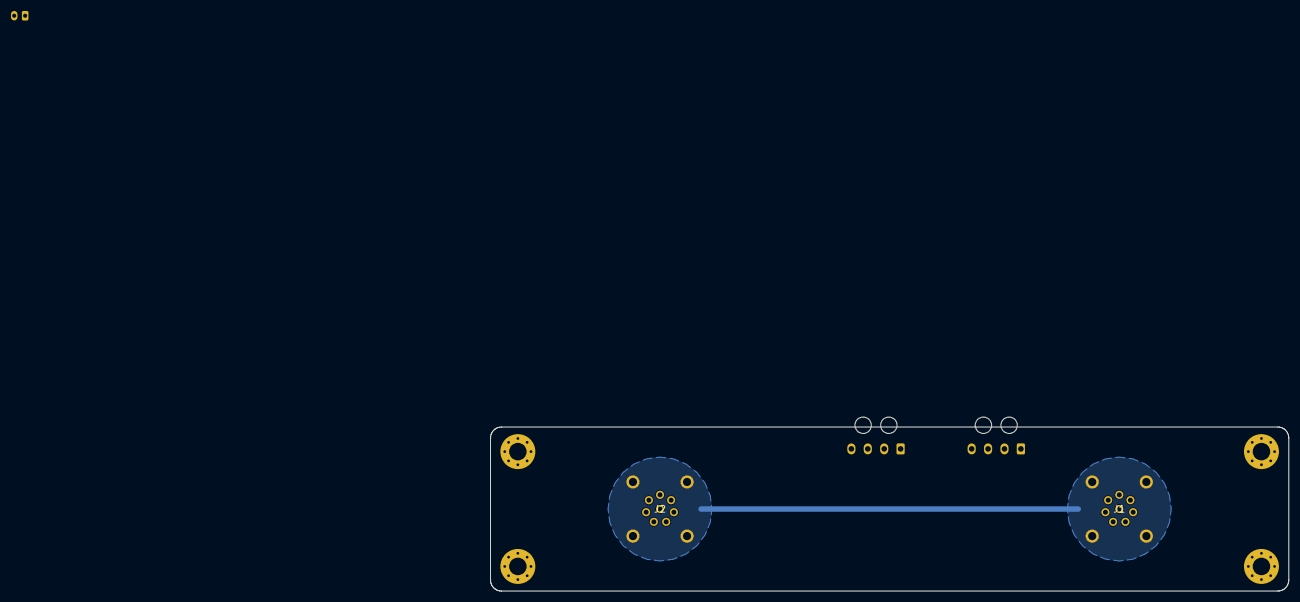
[picture p61: board HG1-PWR.kicad_pcb from below]

Board: 6 copper layers, 146.0 x 30.0 mm, 67 parts (2 on the bottom side), 68 nets.
