ajisrawi/hologuard-hg1-radar/(commit log)

2026-10-07 HoloGuard HG-1: Ku-band GaN 4D holographic counter-UAS radar
    System design and link budget, 6TX x 48RX MIMO antenna, KiCad boards
    (0 DRC errors), FreeCAD enclosure, Blender renders, and firmware
    (Versal DSP chain + tracker, STM32 GaN sequencer) with simulation-based
    verification.
    [BOM_HG1.csv, HG1-ANT.kicad_pcb, HG1-DSP.kicad_pcb, HG1-PWR.kicad_pcb, HG1_enclosure.FCStd, HG1_enclosure.step, HG1_scene.blend, absorber.stl]
2026-10-08 Schematics, full-wave EM element optimisation, physical stack-ups
    Schematics
    - KiCad schematics for HG1-ANT/DSP/PWR generated by board/schematic/
    (33-symbol HG1 library, pins taken from the routed layout): ERC 0/0,
    schematic<->PCB parity clean; scripted "Update PCB from Schematic"
    links footprints, nets and values and stages unplaced parts.
    - STM32G474 pin map corrected to the real LQFP-64 pin-out.
    Full-wave EM of the radiating element (antenna/em, docs/06)
    - EMerge FEM models: isolated element and infinite-array unit cell with
    a scan-matched Floquet port; local PARDISO and Modal (CPU, cuDSS GPU).
    - Found and fixed: low slot/superstrate resonance of the analytic cut,
    60 deg azimut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
    [HG1-ANT.kicad_pcb, HG1-ANT.kicad_sch, HG1-DSP.kicad_pcb, HG1-DSP.kicad_sch, HG1-PWR.kicad_pcb, HG1-PWR.kicad_sch, HG1_enclosure.FCStd, HG1_enclosure.step]
